jadoo-tech/Exoskeleton_public/README.md

# This project has moved

Development continues in **[jadoo-tech/unified_server](https://github.com/jadoo-tech/unified_server)**.

Contact **Dr. Waqas Khalid** for GitHub access.
