jadoo-tech/Exoskeleton_public/Kicad Files/EEG kicad/report.txt

Plotted to '/Users/ynk/Desktop/beyond curriculum/Nanotech/Exoskeleton/Exoskeleton_public/Kicad Files/EEG kicad/EEG2-F_Cu.gbr'.
Plotted to '/Users/ynk/Desktop/beyond curriculum/Nanotech/Exoskeleton/Exoskeleton_public/Kicad Files/EEG kicad/EEG2-B_Cu.gbr'.
Plotted to '/Users/ynk/Desktop/beyond curriculum/Nanotech/Exoskeleton/Exoskeleton_public/Kicad Files/EEG kicad/EEG2-F_Paste.gbr'.
Plotted to '/Users/ynk/Desktop/beyond curriculum/Nanotech/Exoskeleton/Exoskeleton_public/Kicad Files/EEG kicad/EEG2-B_Paste.gbr'.
Plotted to '/Users/ynk/Desktop/beyond curriculum/Nanotech/Exoskeleton/Exoskeleton_public/Kicad Files/EEG kicad/EEG2-F_Silkscreen.gbr'.
Plotted to '/Users/ynk/Desktop/beyond curriculum/Nanotech/Exoskeleton/Exoskeleton_public/Kicad Files/EEG kicad/EEG2-B_Silkscreen.gbr'.
Plotted to '/Users/ynk/Desktop/beyond curriculum/Nanotech/Exoskeleton/Exoskeleton_public/Kicad Files/EEG kicad/EEG2-F_Mask.gbr'.
Plotted to '/Users/ynk/Desktop/beyond curriculum/Nanotech/Exoskeleton/Exoskeleton_public/Kicad Files/EEG kicad/EEG2-B_Mask.gbr'.
Plotted to '/Users/ynk/Desktop/beyond curriculum/Nanotech/Exoskeleton/Exoskeleton_public/Kicad Files/EEG kicad/EEG2-Edge_Cuts.gbr'.
Created Gerber job file '/Users/ynk/Desktop/beyond curriculum/Nanotech/Exoskeleton/Exoskeleton_public/Kicad Files/EEG kicad/EEG2-job.gbrjob'.
Info: Done.
