jadoo-tech/Exoskeleton_public/Kicad Files/AR Glass/AugmentedGlassesPinout_v1.pdf

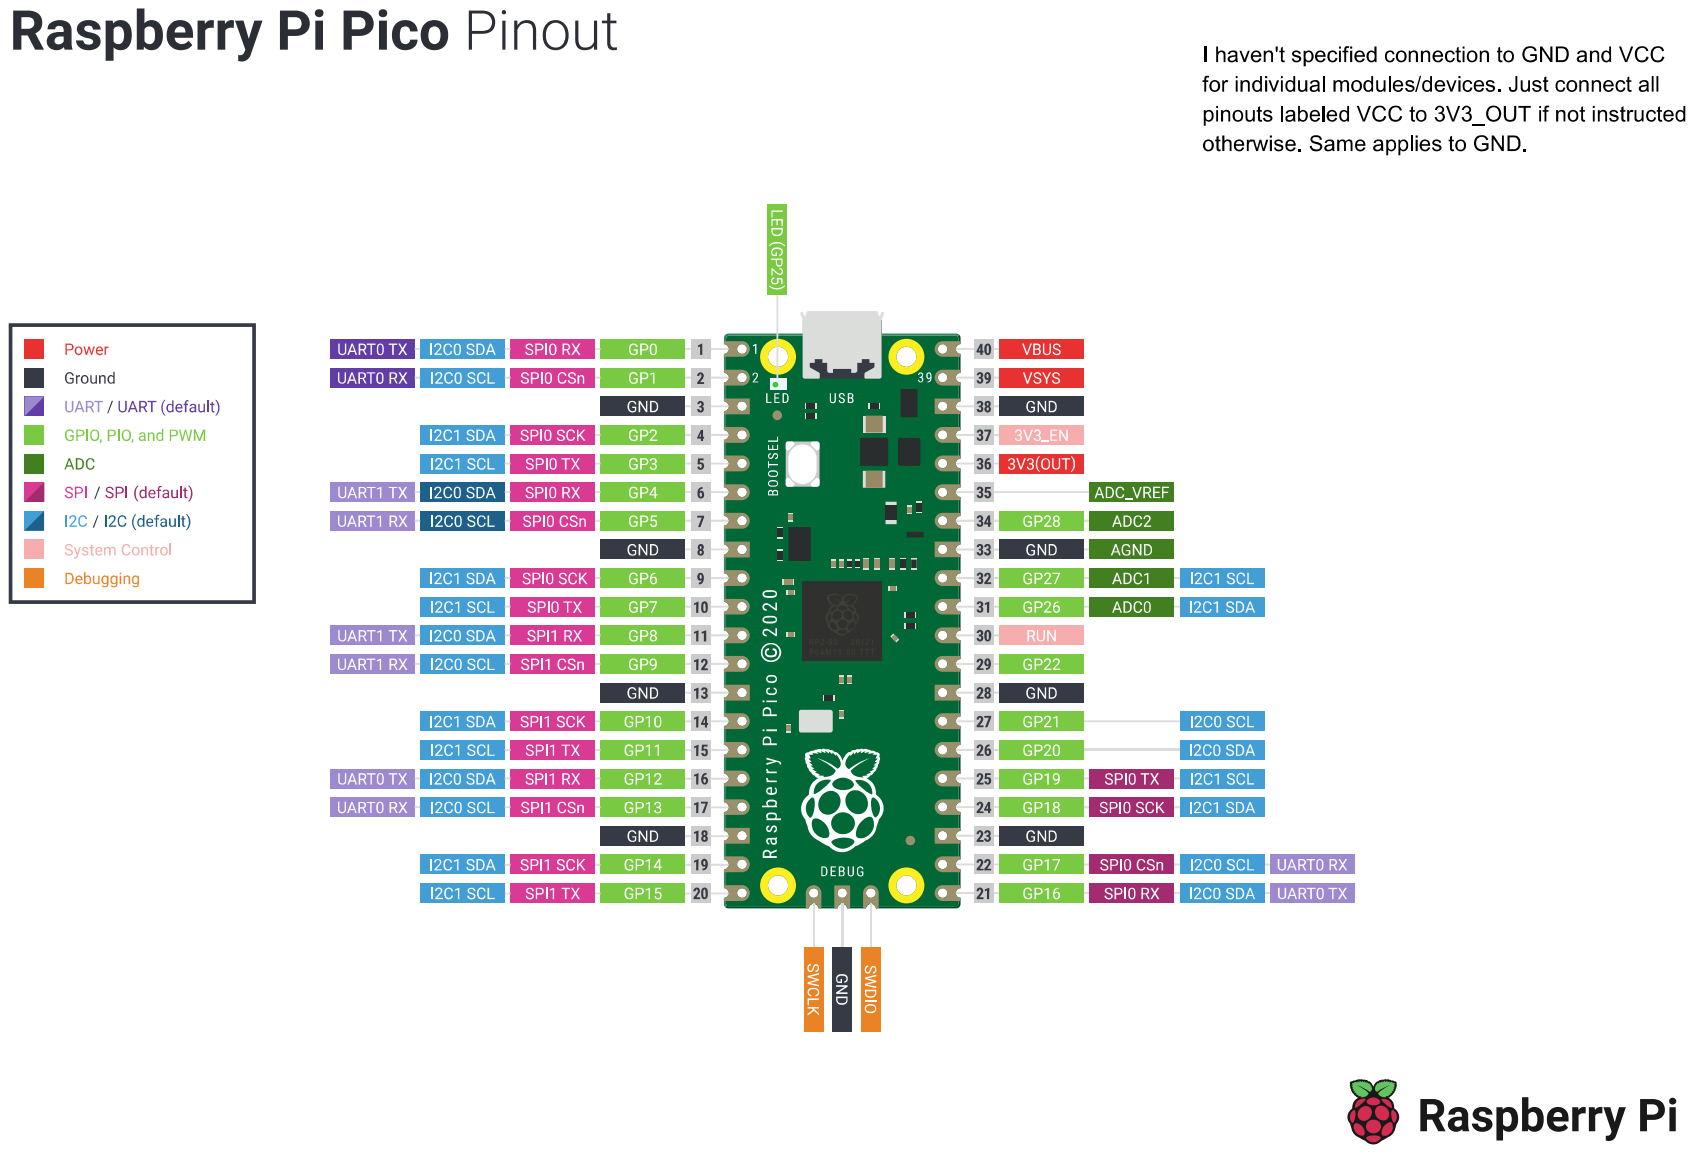
[picture p1: page 1]

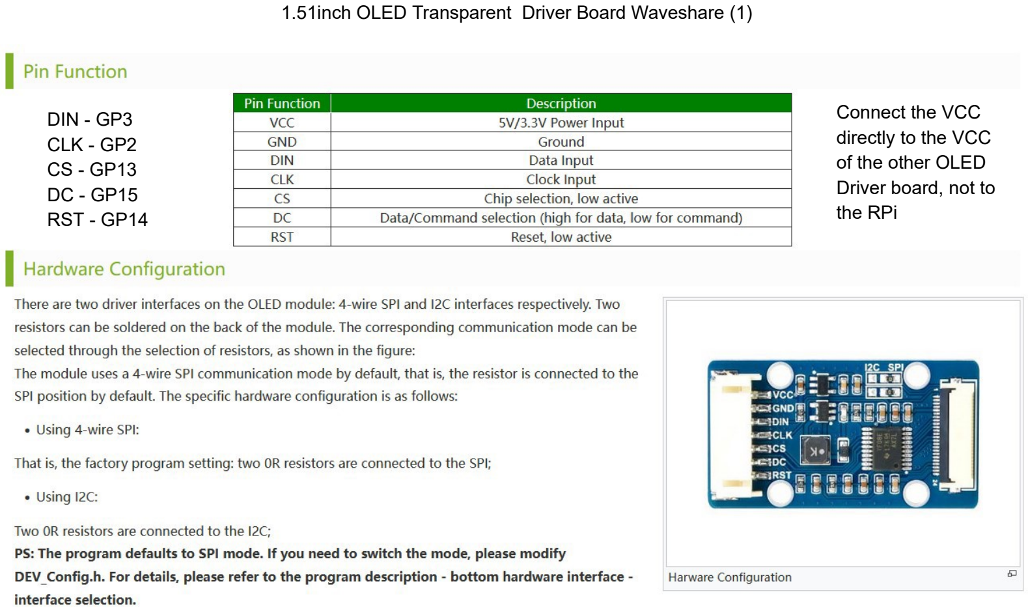
[picture p2: page 2]

1.51inch OLED Transparent Driver Board Waveshare (1)

DIN - GP3
CLK - GP2
CS - GP13
DC - GP15
RST - GP14

Connect the VCC
directly to the VCC
of the other OLED
Driver board, not to
the RPi

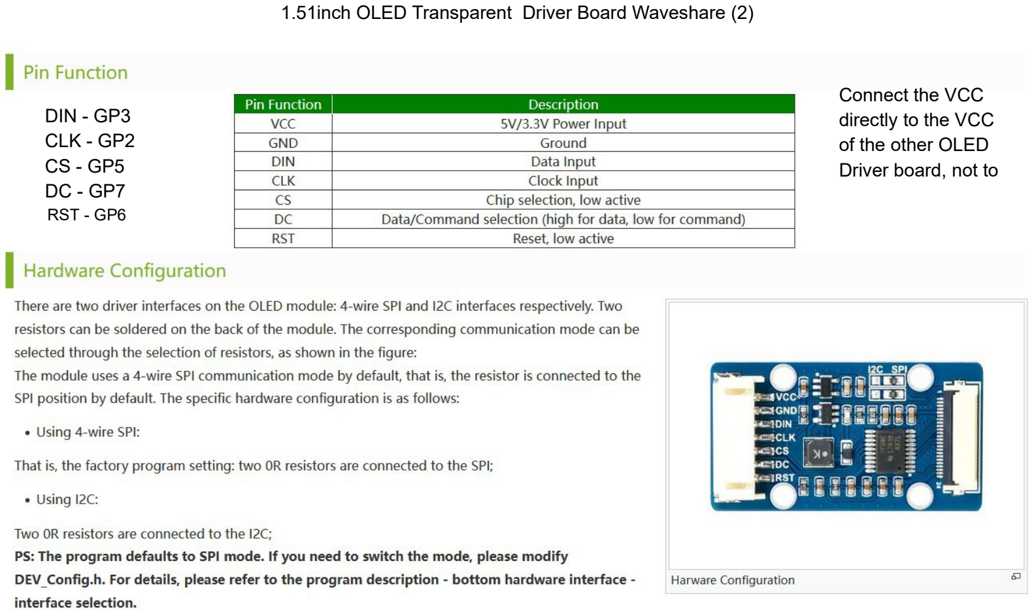
[picture p3: page 3]

1.51inch OLED Transparent Driver Board Waveshare (2)

DIN - GP3
CLK - GP2
CS - GP5
DC - GP7

Connect the VCC
directly to the VCC
of the other OLED
Driver board, not to

RST - GP6

### HM01B0 Arducam Camera Module

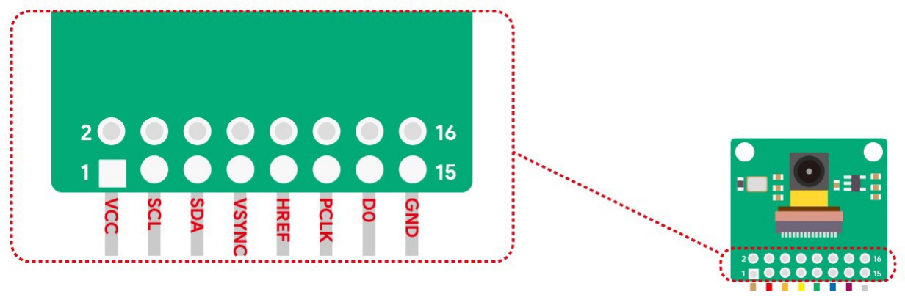
[picture p4: figure]

### SCL - GP21 SDA - GP20 VSYNC - GP16 HREF - GP19 PCLK - GP18 DO - GP10
