jadoo-tech/Exoskeleton_public/Kicad Files/EEG/FFT .png

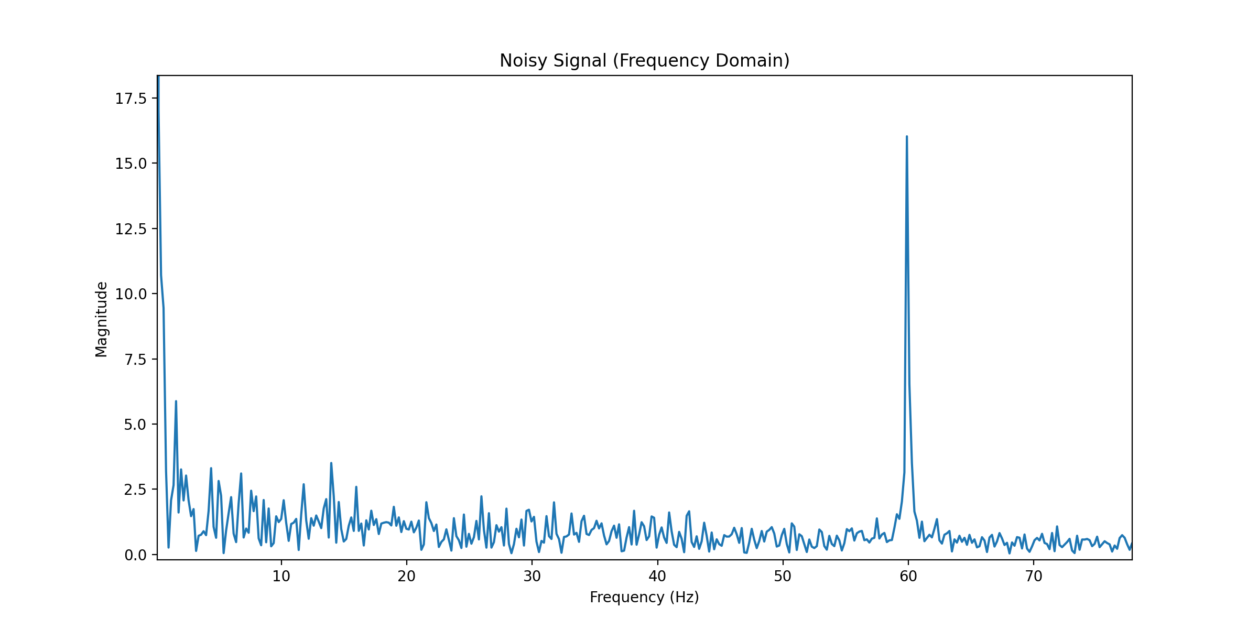
Kicad Files/EEG/FFT .png
