jadoo-tech/Exoskeleton_public/Kicad Files/EEG/filtered.png

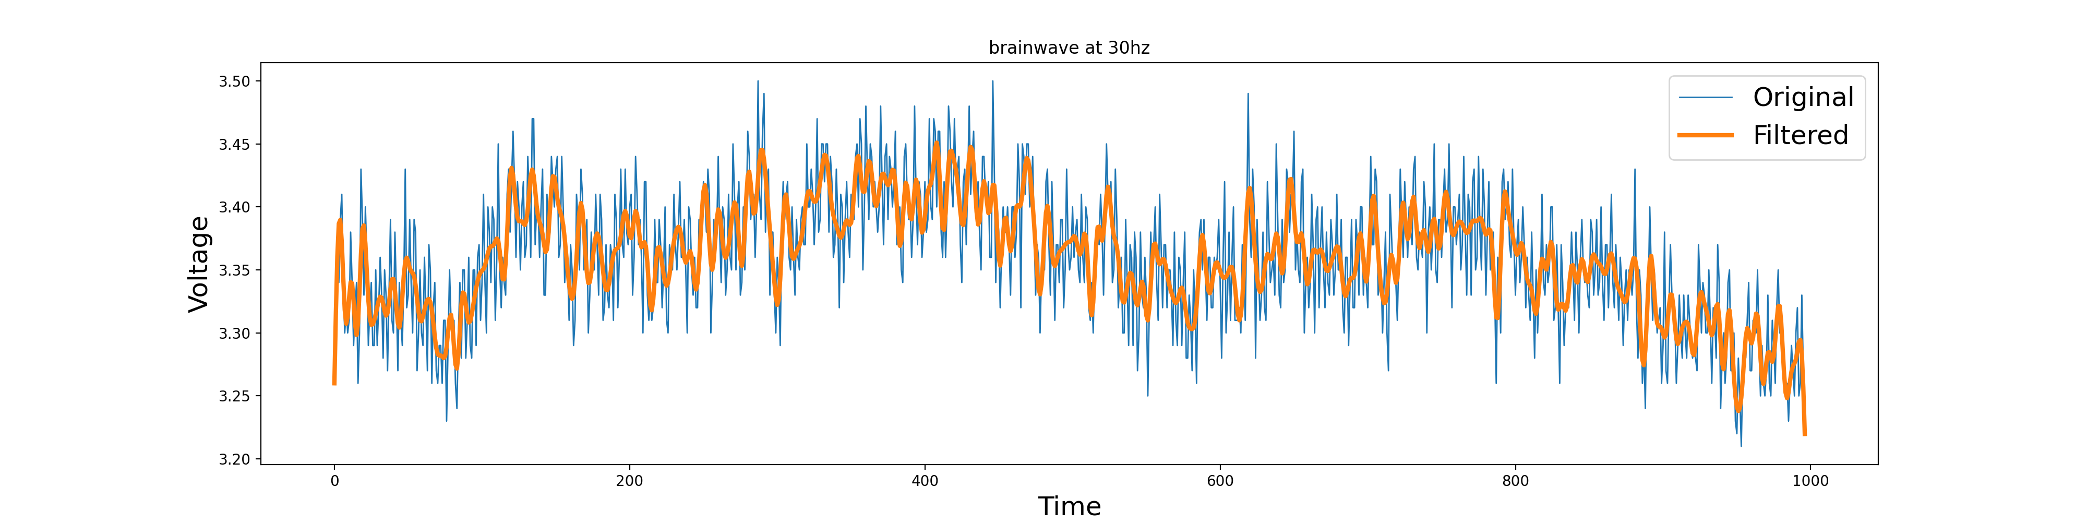
Kicad Files/EEG/filtered.png
