jadoo-tech/Exoskeleton_public/Kicad Files/EEG/output.png

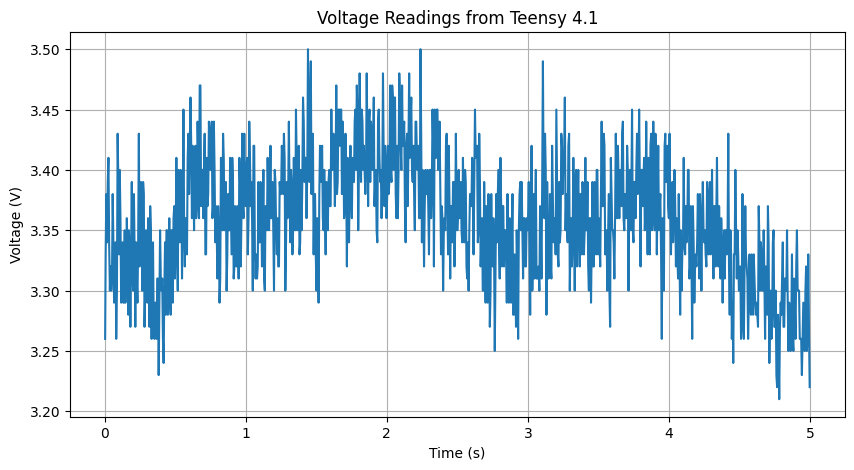
Kicad Files/EEG/output.png
