jadoo-tech/Exoskeleton_public/Microcontroller Codes/Motor/Connection.jpeg

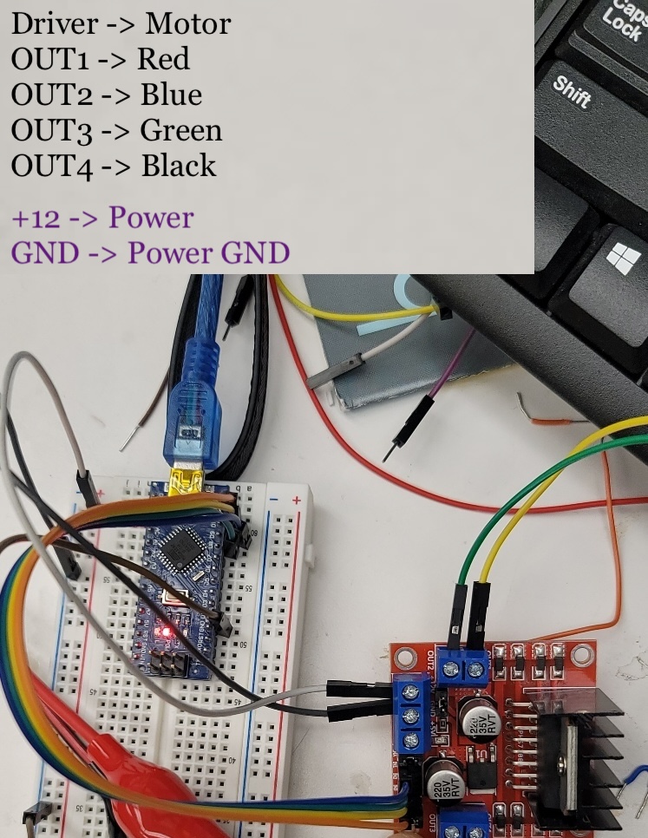
Microcontroller Codes/Motor/Connection.jpeg
