jadoo-tech/Exoskeleton_public/Microcontroller Codes/Motor/Motor_Specification.png

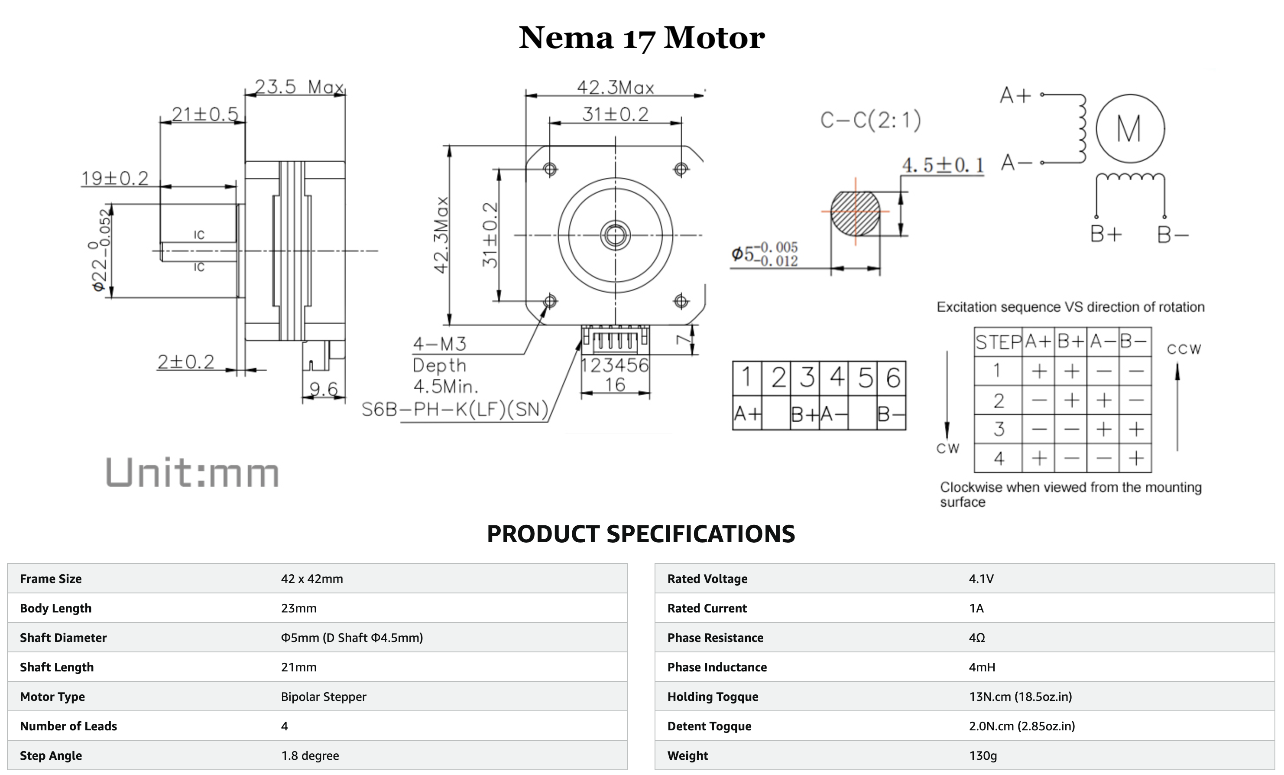
Microcontroller Codes/Motor/Motor_Specification.png
