jadoo-tech/Exoskeleton_public/Kicad Files/EEG kicad — no golden fingers/EEGBOM.xls

Reference | Value | Datasheet | Footprint | Qty | Unit price | Total price ($) | Product Link
C1,C2,C3,C7,C8,C9,C10,C14,C15,C16,C17,C18,C19,C20,C27,C28,C29,C30,C31,C35,C36,C37,C38,C39,C40,C41,C42,C43,C44,C45,C46,C47,C48,C49,C50,C85,C86,C87,C88,C89,C94,C96,C97,C98,C99,C143,C144,C145,C146,C147 | 1uF | ~ | Capacitor_SMD:C_0805_2012Metric | 50 | 0.84 | 42 | https://www.digikey.com/en/products/detail/yageo/CC0805JKX7R9BB105/7164382
C4,C5,C6,C11,C12,C13,C21,C22,C23,C24,C25,C26,C32,C33,C34,C100,C101,C102,C103,C104,C105,C106,C107,C108,C109,C110,C111,C112,C141,C142 | 0.22uF | ~ | Capacitor_SMD:C_0603_1608Metric | 30 | 2.986 | 89.58 | https://www.digikey.com/en/products/detail/kemet/C1206C224F3JACTU/6178652
J1 | Conn_01x05_Pin | ~ | Connector_PinHeader_1.27mm:PinHeader_1x05_P1.27mm_Vertical | 1 |  | 0
J2 | Conn_01x11_Pin | ~ | Connector_PinHeader_1.27mm:PinHeader_1x11_P1.27mm_Vertical | 1 |  | 0
R1,R6,R9,R10,R13,R18,R21,R22,R25,R26,R34,R36,R41,R42,R43,R44,R49,R54,R57,R58,R145,R146,R147,R148,R149,R166,R168,R170,R173,R176,R185,R186,R187,R188,R189,R190,R191,R192,R242,R243 | 1k | ~ |  | 40 | 0.02 | 0.8 | https://www.digikey.com/en/products/detail/panasonic-electronic-components/ERJ-2RKF1001X/79729
R2,R4,R14,R16,R27,R28,R31,R32,R50,R52,R150,R151,R152,R154,R156,R160,R161,R162,R163,R164 | 2652 | ~ |  | 20 | 0.11 | 2.2 | https://www.digikey.com/en/products/detail/yageo/RT0603BRD072K64L/5927921
R3,R15,R29,R30,R51,R153,R155,R157,R158,R159 | 1326 | ~ |  | 10 | 0.97 | 9.7 | https://www.digikey.com/en/products/detail/koa-speer-electronics-inc/RN73R2ATTD1321B05/10024879
R5,R17,R33,R35,R53,R165,R167,R169,R172,R175 | 100 | ~ |  | 10 | 0.1 | 1 | https://www.digikey.com/en/products/detail/panasonic-electronic-components/ERA-6AEB101V/1465724
R7,R8,R11,R19,R20,R23,R37,R38,R39,R40,R45,R46,R55,R56,R59,R171,R174,R177,R178,R179,R180,R181,R182,R183,R184,R241,R244,R245,R246,R247 | 10k | ~ |  | 30 | 0.106 | 3.18 | https://www.digikey.com/en/products/detail/yageo/RT0603BRD0710KL/1072198
R12,R24,R47,R48,R60,R248,R249,R250,R251,R252 | 150k | ~ |  | 10 | $0.01 | 0.14 | https://www.digikey.com/en/products/detail/stackpole-electronics-inc/RMCF0402FT150K/1761849
U1,U14,U25,U26,U32,U124,U125,U126,U127,U128 | AD5293 | https://www.analog.com/media/en/technical-documentation/data-sheets/AD5293.pdf | Package_SO:TSSOP-14_4.4x5mm_P0.65mm | 10 | $5.52 | 55.16 | https://www.digikey.com/en/products/detail/analog-devices-inc/AD5293BRUZ-100/2237577
U2,U9,U15,U16,U27,U75,U76,U77,U78,U79 | INA823 | https://www.ti.com/lit/ds/symlink/ina333.pdf | Package_SO:VSSOP-8_3x3mm_P0.65mm | 10 | 1.833 | 18.33 | https://www.digikey.com/en/products/detail/texas-instruments/INA823DR/15853913
U3,U4,U5,U6,U10,U11,U12,U13,U17,U18,U19,U20,U21,U22,U23,U24,U28,U29,U30,U31,U80,U81,U82,U83,U84,U85,U86,U87,U88,U89,U90,U91,U92,U93,U94,U95,U96,U97,U98,U123 | LF356N | http://www.ti.com/lit/ds/symlink/lf357.pdf |  | 40 | 1.038 | 41.52 | https://www.digikey.com/en/products/detail/texas-instruments/LF356M/3701382
U7 | Teensy4.1 |  | EEG Project:Teensy41 | 1 | 39.6 | 39.6 | https://www.digikey.com/en/products/detail/sparkfun-electronics/DEV-16996/13158152
