jadoo-tech/Exoskeleton_public/Kicad Files/AR Glass/dxf/Glass-Edge_Cuts.dxf

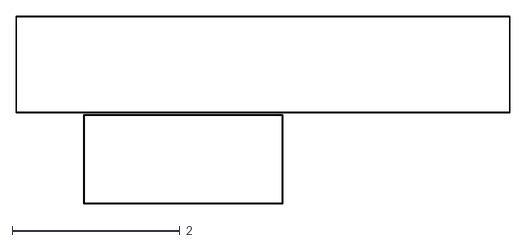
[picture p10: CAD file, 2024-10-15]
Kicad Files/AR Glass/dxf/Glass-Edge_Cuts.dxf
5.89 x 2.24
