jadoo-tech/Exoskeleton_public/Kicad Files/KiCad Libraries/AD5293/AD5293.step

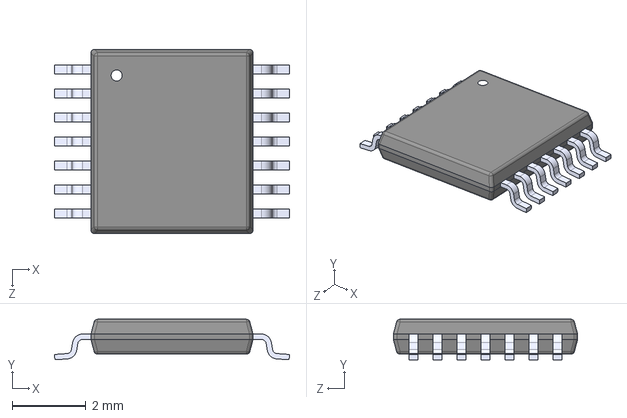
[picture p11: CAD file, 2024-11-18]
Kicad Files/KiCad Libraries/AD5293/AD5293.step
6.38 x 1.10 x 5.00 mm
