jadoo-tech/Exoskeleton_public/Kicad Files/KiCad Libraries/LF356M/LF356M.step

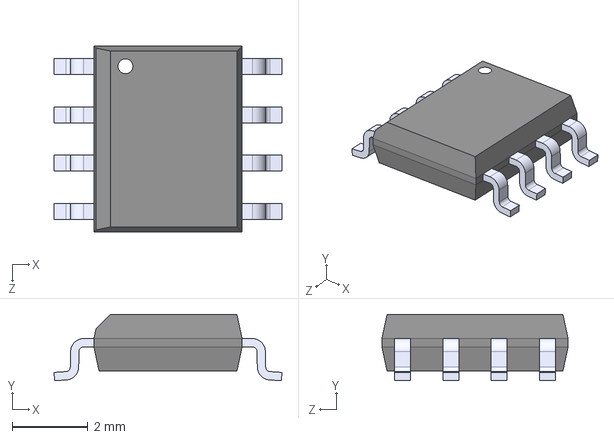
[picture p12: CAD file, 2024-11-18]
Kicad Files/KiCad Libraries/LF356M/LF356M.step
6.00 x 1.75 x 4.90 mm
