jadoo-tech/Exoskeleton_public/Kicad Files/AR Glass/dxf/Glass-B_Cu.dxf

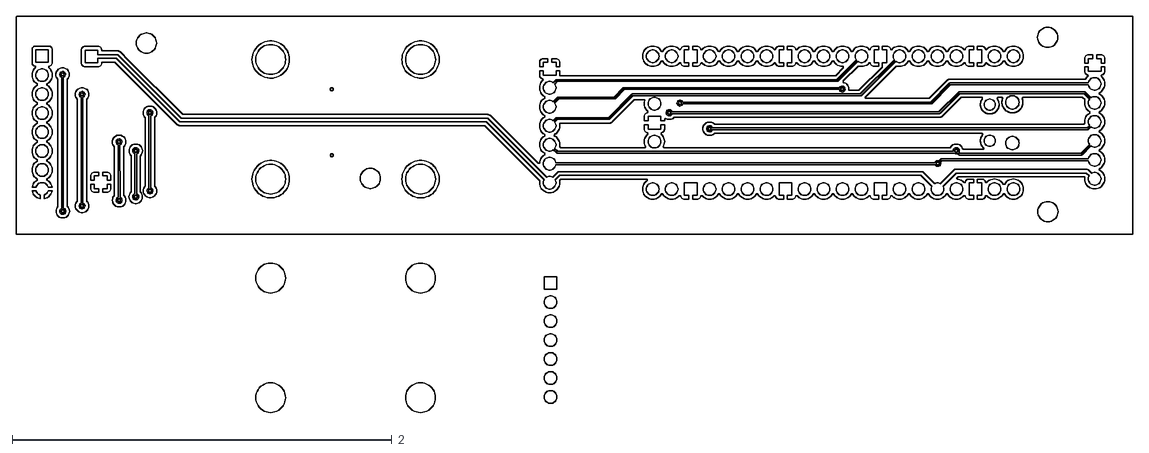
[picture p13: CAD file, 2024-10-15]
Kicad Files/AR Glass/dxf/Glass-B_Cu.dxf
5.88 x 2.09
