jadoo-tech/Exoskeleton_public/Kicad Files/AR Glass/dxf/Glass-F_Cu.dxf

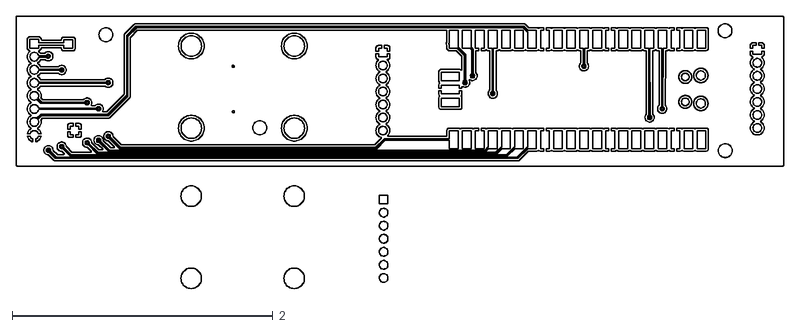
[picture p14: CAD file, 2024-10-15]
Kicad Files/AR Glass/dxf/Glass-F_Cu.dxf
5.88 x 2.09
