jadoo-tech/Exoskeleton_public/(list of files, cad)

Other CAD files:
Kicad Files/AR Glass/dxf/Glass-B_Mask.dxf
Kicad Files/AR Glass/dxf/Glass-B_Paste.dxf
Kicad Files/AR Glass/dxf/Glass-B_Silkscreen.dxf
Kicad Files/AR Glass/dxf/Glass-F_Mask.dxf
Kicad Files/AR Glass/dxf/Glass-F_Paste.dxf
Kicad Files/AR Glass/dxf/Glass-F_Silkscreen.dxf
