jadoo-tech/Exoskeleton_public/Kicad Files/EEG/EEG2.pdf

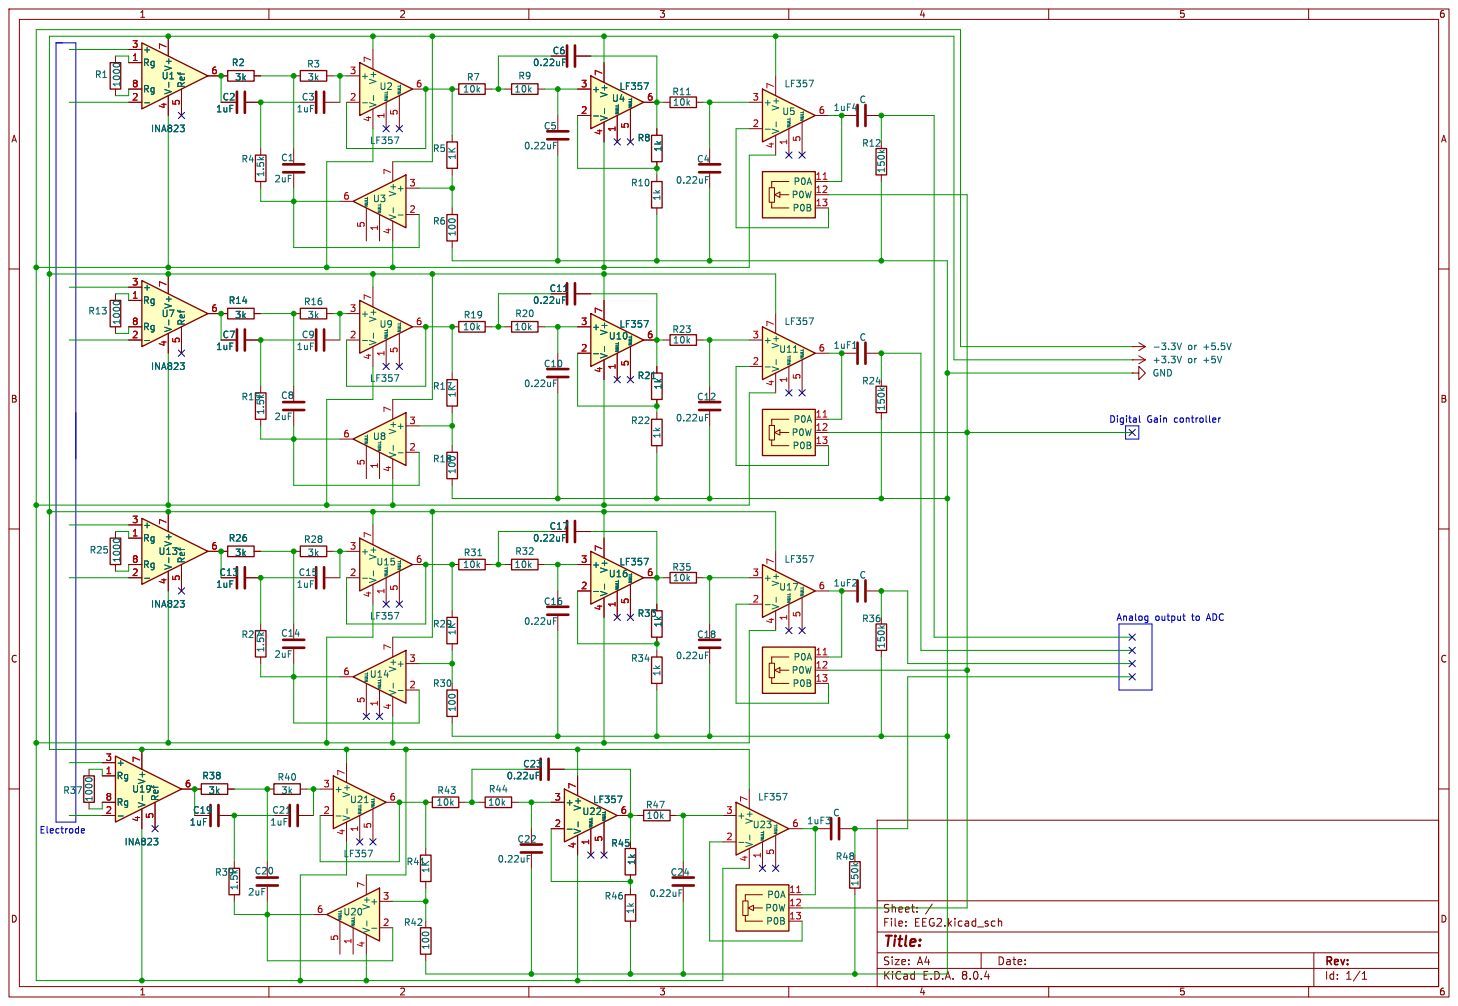
[picture p17: page 1]

Id: 1/1 Title: File: EEG2.kicad_sch Sheet: /
