jadoo-tech/Exoskeleton_public/Kicad Files/Old/EEG Circuits/Schematic_v1.pdf

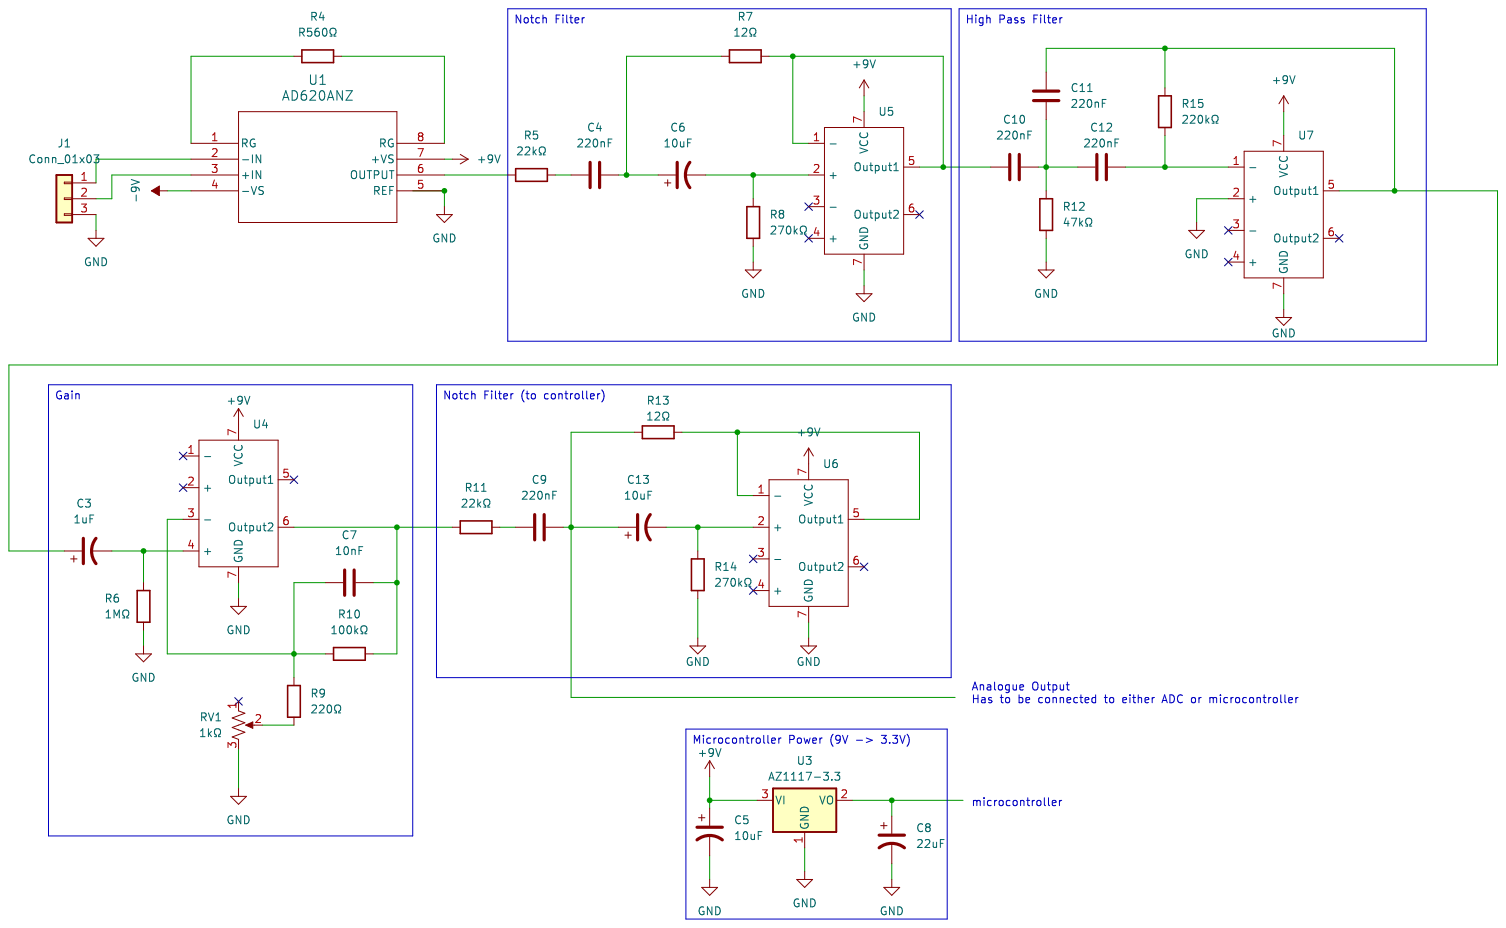
[picture p18: page 1]
