jadoo-tech/Exoskeleton_public/Kicad Files/Heater/Limb_Circuit.kicad_pcb

## KiCad design Kicad Files/Heater/Limb_Circuit.kicad_pcb (2025-03-16)

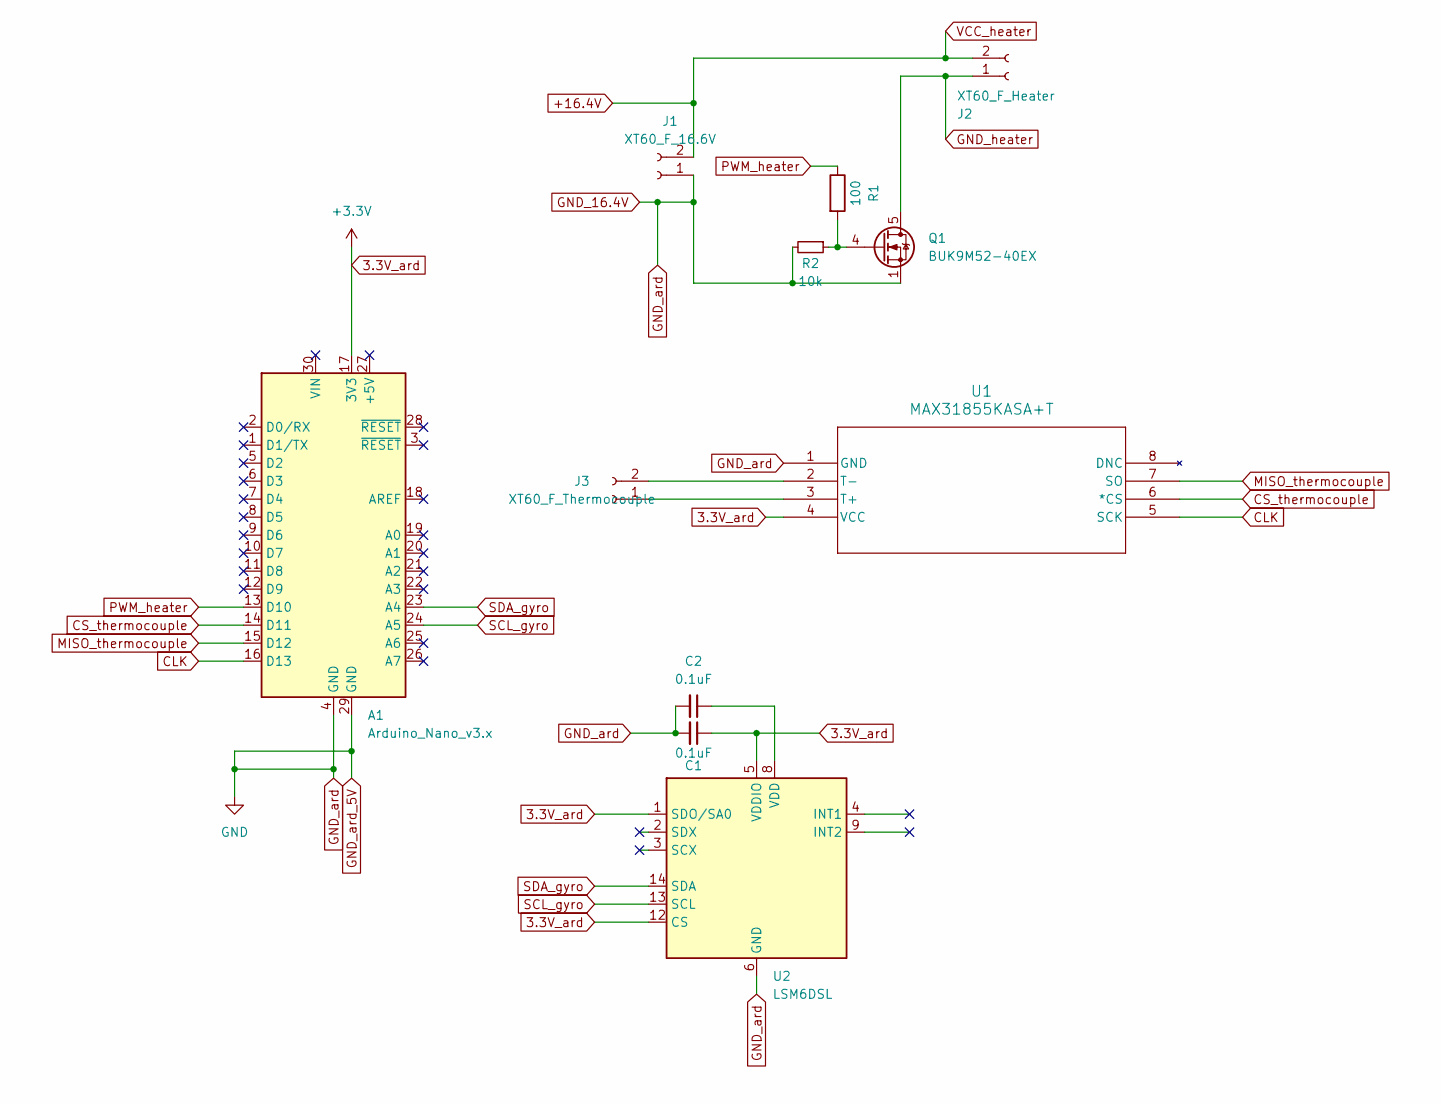
[picture p19: schematic Limb_Circuit.kicad_sch]

Parts:
A1: Arduino_Nano_v3.x; Arduino_Nano
C1, C2: 0.1uF; C_0402_1005Metric
J1: XT60_F_16.6V; AMASS_XT60PW-M_1x02_P7.20mm_Horizontal
J2: XT60_F_Heater; AMASS_XT60PW-M_1x02_P7.20mm_Horizontal
J3: XT60_F_Thermocouple; AMASS_XT60PW-M_1x02_P7.20mm_Horizontal
Q1: BUK9M52-40EX; LFPAK33
R1: 100; R_0805_2012Metric
R2: 10k; R_0805_2012Metric
U1: MAX31855KASA+T; 21-0041B_8_MXM
U2: LSM6DSL; LGA-14_3x2.5mm_P0.5mm_LayoutBorder3x4y

Connections:
3.3V_ard: A1.17 (3V3), C1.1, U1.4 (VCC), U2.1 (SDO/SA0), U2.5 (VDDIO), U2.12 (CS)
+16.4V: J1.2, J2.2
CLK: A1.16 (D13), U1.5 (SCK)
CS_thermocouple: A1.14 (D11), U1.6 (*CS)
GND_16.4V: A1.4 (GND), A1.29 (GND), C1.2, C2.2, J1.1, Q1.1 (S), Q1.2 (S), Q1.3 (S), R2.2, U1.1 (GND), U2.6 (GND), U2.7 (GND)
GND_heater: J2.1, Q1.5 (D)
MISO_thermocouple: A1.15 (D12), U1.7 (SO)
unnamed: J3.1, U1.3 (T+)
unnamed: J3.2, U1.2 (T-)
unnamed: Q1.4 (G), R1.2, R2.1
unnamed: C2.1, U2.8 (VDD)
PWM_heater: A1.13 (D10), R1.1
SCL_gyro: A1.24 (A5), U2.13 (SCL)
SDA_gyro: A1.23 (A4), U2.14 (SDA)

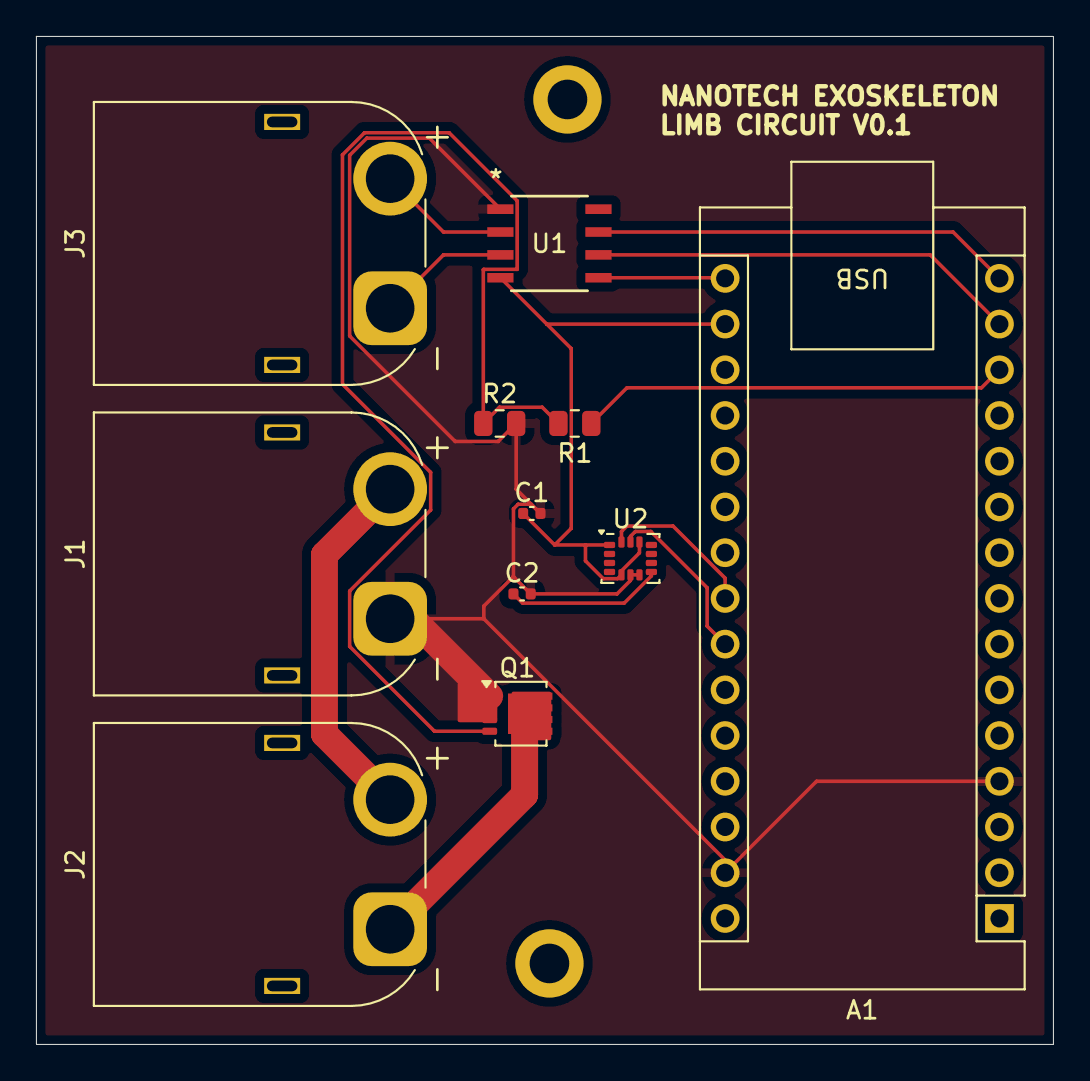
[picture p20: board Limb_Circuit.kicad_pcb from above]

Board: 2 copper layers, 56.5 x 56.0 mm, 11 parts (0 on the bottom side), 14 nets.
