jadoo-tech/Exoskeleton_public/Kicad Files/AR Glass/Glass.kicad_pcb

## KiCad design Kicad Files/AR Glass/Glass.kicad_pcb (2025-06-09)

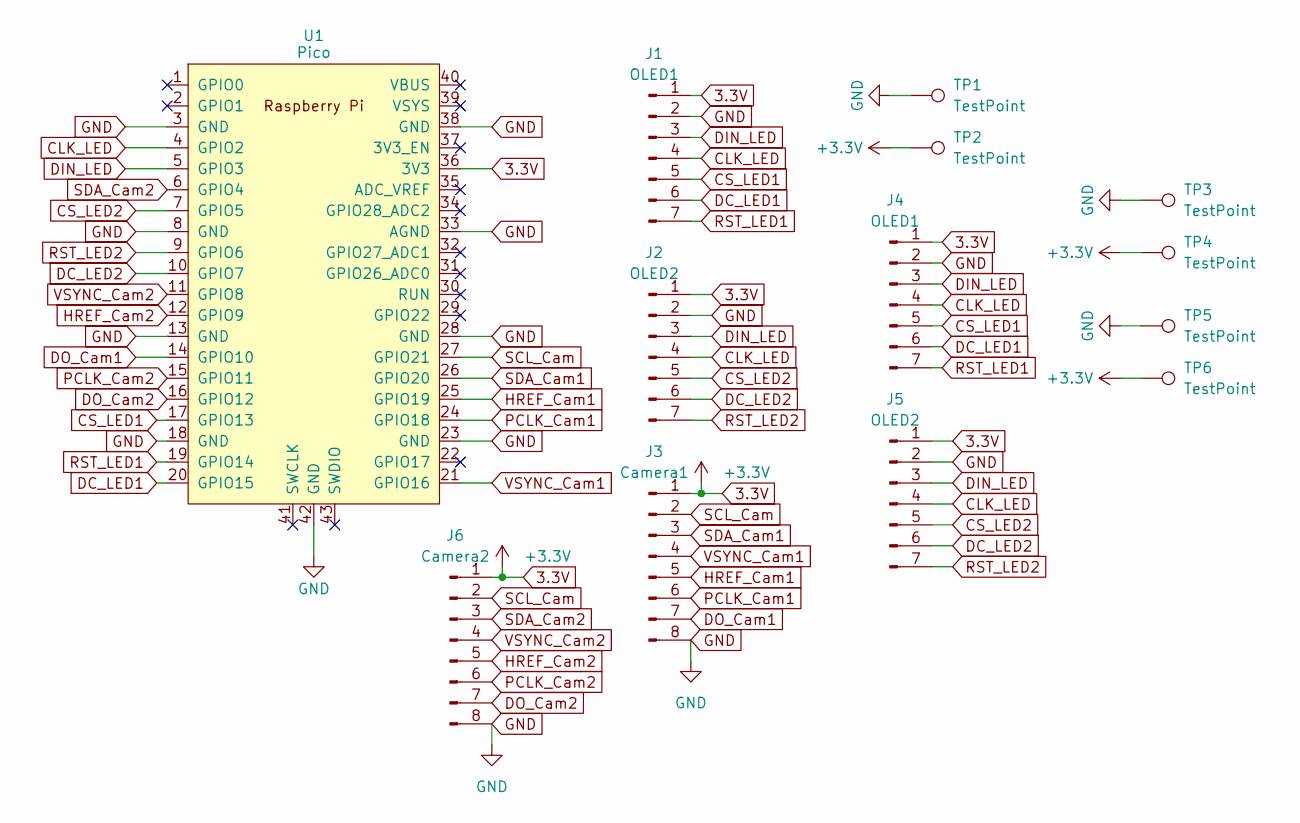
[picture p21: schematic Glass.kicad_sch]

Parts:
J1, J4: OLED1; Molex_54548-1071_1x10-1MP_P0.5mm_Horizontal
J2, J5: OLED2; Molex_54548-1071_1x10-1MP_P0.5mm_Horizontal
J3: Camera1; Molex_54548-1071_1x10-1MP_P0.5mm_Horizontal
J6: Camera2; Molex_54548-1071_1x10-1MP_P0.5mm_Horizontal
TP1, TP2, TP3, TP4, TP5, TP6: TestPoint; PinHeader_1x01_P2.54mm_Vertical
U1: Pico; RPi_Pico_SMD_TH

Connections:
3.3V: J1.1, J2.1, J3.1, J4.1, J5.1, J6.1, TP2.1, TP4.1, TP6.1, U1.36 (3V3)
CLK_LED: J1.4, J2.4, J4.4, J5.4, U1.4 (GPIO2)
CS_LED1: J1.5, J4.5, U1.17 (GPIO13)
CS_LED2: J2.5, J5.5, U1.7 (GPIO5)
DC_LED1: J1.6, J4.6, U1.20 (GPIO15)
DC_LED2: J2.6, J5.6, U1.10 (GPIO7)
DIN_LED: J1.3, J2.3, J4.3, J5.3, U1.5 (GPIO3)
DO_Cam1: J3.7, U1.14 (GPIO10)
DO_Cam2: J6.7, U1.16 (GPIO12)
GND: J1.2, J2.2, J3.8, J4.2, J5.2, J6.8, TP1.1, TP3.1, TP5.1, U1.3 (GND), U1.8 (GND), U1.13 (GND), U1.18 (GND), U1.23 (GND), U1.28 (GND), U1.33 (AGND), U1.38 (GND), U1.42 (GND)
HREF_Cam1: J3.5, U1.25 (GPIO19)
HREF_Cam2: J6.5, U1.12 (GPIO9)
PCLK_Cam1: J3.6, U1.24 (GPIO18)
PCLK_Cam2: J6.6, U1.15 (GPIO11)
RST_LED1: J1.7, J4.7, U1.19 (GPIO14)
RST_LED2: J2.7, J5.7, U1.9 (GPIO6)
SCL_Cam: J3.2, J6.2, U1.27 (GPIO21)
SDA_Cam1: J3.3, U1.26 (GPIO20)
SDA_Cam2: J6.3, U1.6 (GPIO4)
VSYNC_Cam1: J3.4, U1.21 (GPIO16)
VSYNC_Cam2: J6.4, U1.11 (GPIO8)

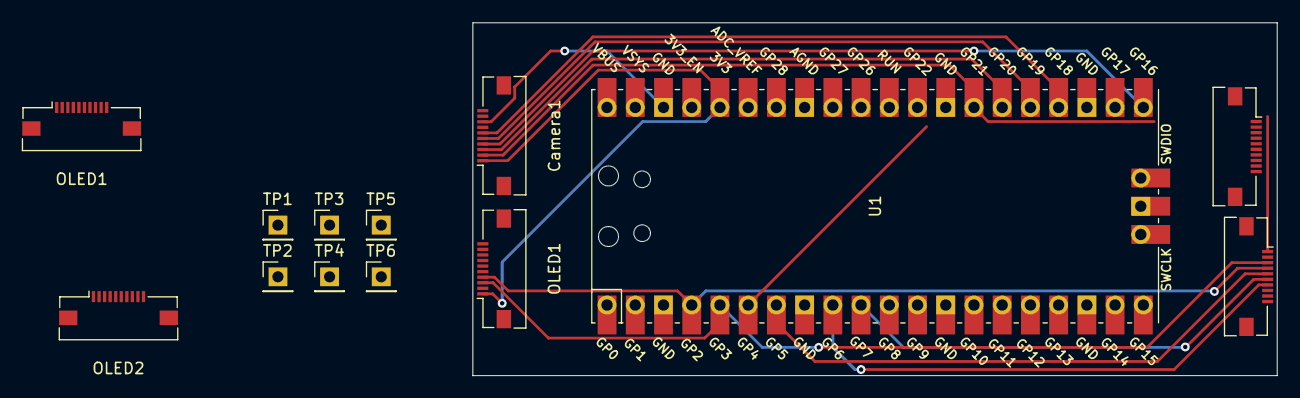
[picture p22: board Glass.kicad_pcb from above]

Board: 2 copper layers, 72.4 x 31.7 mm, 13 parts (0 on the bottom side), 21 nets.
