jadoo-tech/Exoskeleton_public/Kicad Files/EEG kicad/EEG2.kicad_pcb

## KiCad design Kicad Files/EEG kicad/EEG2.kicad_pcb (2025-03-03)

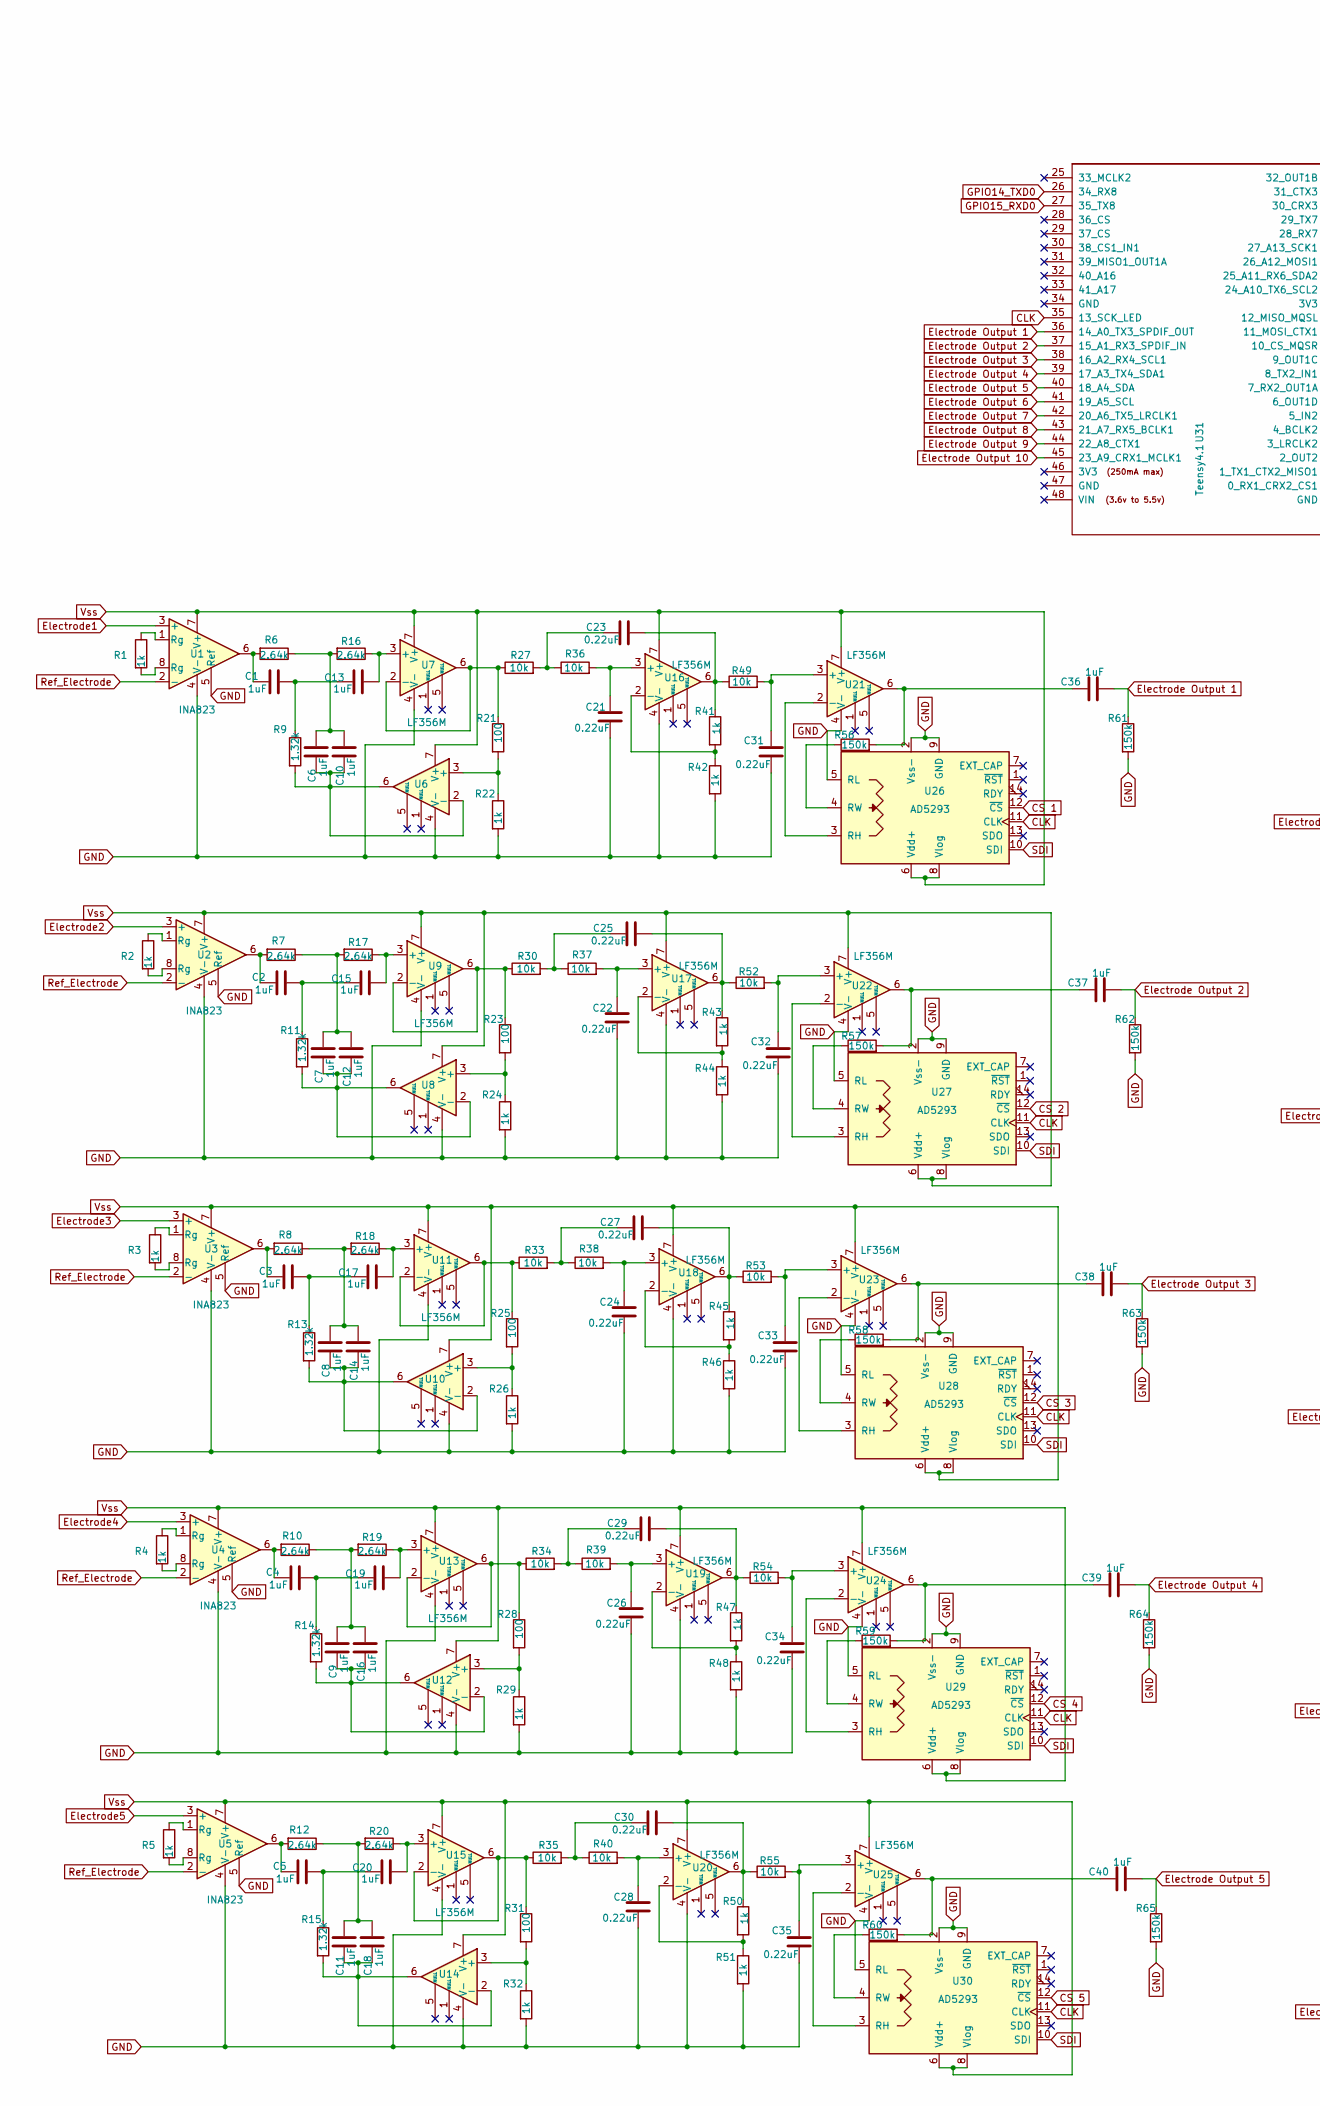
[picture p23: schematic EEG2.kicad_sch, part in row 1, column 1]

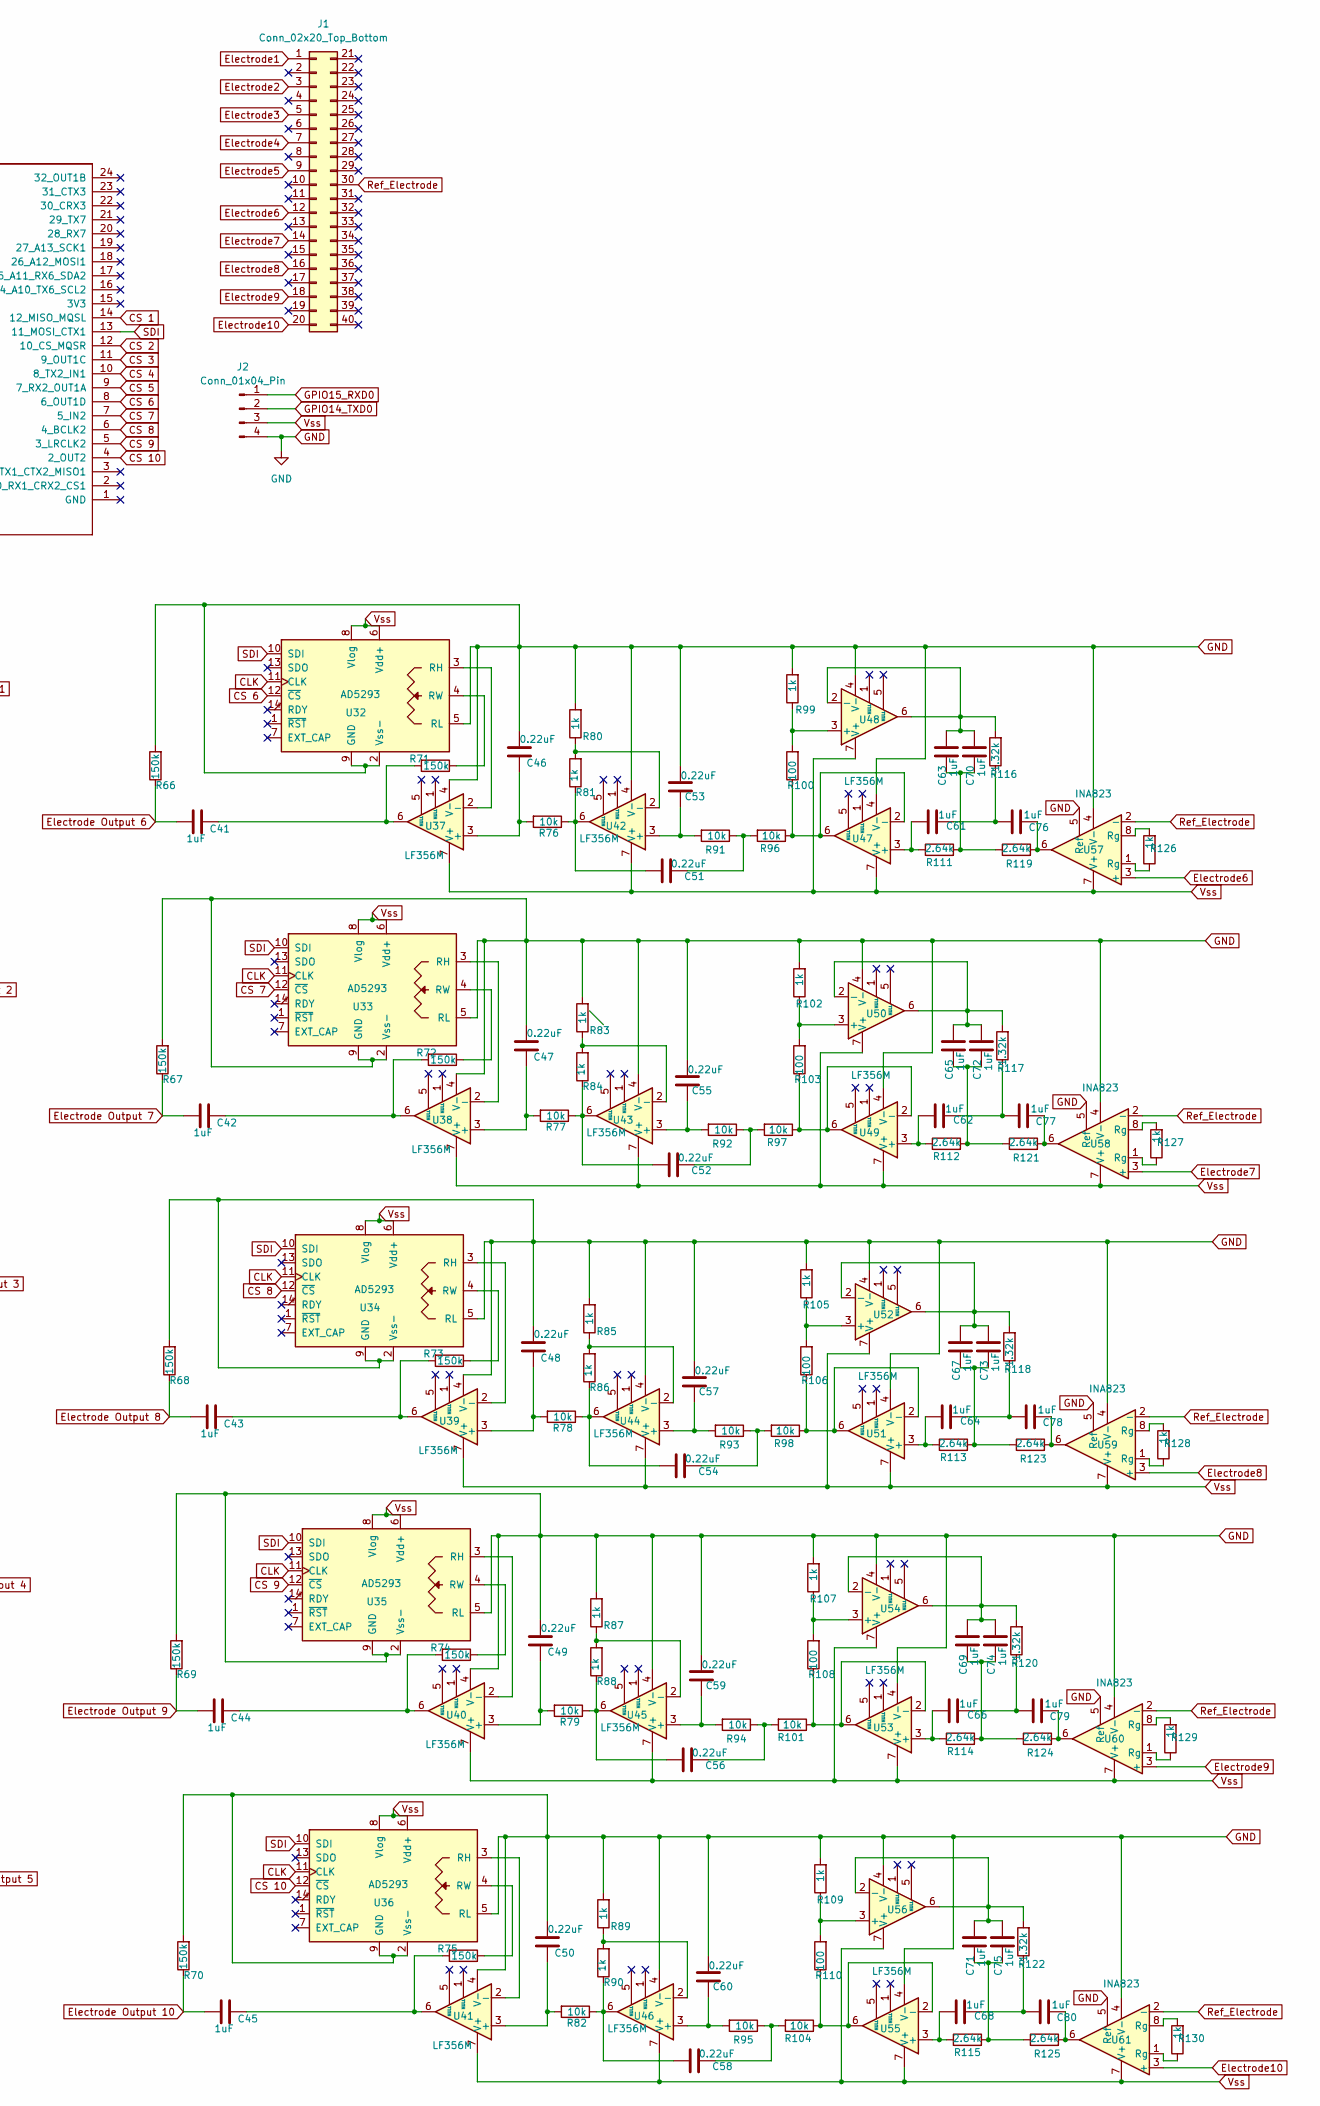
[picture p24: schematic EEG2.kicad_sch, part in row 1, column 2]

Parts:
C1, C2, C3, C4, C5, C6, C7, C8, C9, C10, C11, C12, C13, C14, C15, C16, C17, C18, C19, C20, C36, C37, C38, C39, C40, C41, C42, C43, C44, C45, C61, C62, C63, C64, C65, C66, C67, C68, C69, C70, C71, C72, C73, C74, C75, C76, C77, C78, C79, C80: 1uF; C_0805_2012Metric
C21, C22, C23, C24, C25, C26, C27, C28, C29, C30, C31, C32, C33, C34, C35, C46, C47, C48, C49, C50, C51, C52, C53, C54, C55, C56, C57, C58, C59, C60: 0.22uF; C_0603_1608Metric
J1: Conn_02x20_Top_Bottom; GoldFingers_1x40_0.155mm_DoubleSided
J2: Conn_01x04_Pin; PinHeader_1x04_P1.27mm_Vertical
R1, R2, R3, R4, R5, R22, R24, R26, R29, R32, R41, R42, R43, R44, R45, R46, R47, R48, R50, R51, R80, R81, R83, R84, R85, R86, R87, R88, R89, R90, R99, R102, R105, R107, R109, R126, R127, R128, R129, R130: 1k; R_0402_1005Metric
R6, R7, R8, R10, R12, R16, R17, R18, R19, R20, R111, R112, R113, R114, R115, R119, R121, R123, R124, R125: 2.64k; R_0603_1608Metric
R9, R11, R13, R14, R15, R116, R117, R118, R120, R122: 1.32k; R_0805_2012Metric
R21, R23, R25, R28, R31, R100, R103, R106, R108, R110: 100; R_0805_2012Metric
R27, R30, R33, R34, R35, R36, R37, R38, R39, R40, R49, R52, R53, R54, R55, R76, R77, R78, R79, R82, R91, R92, R93, R94, R95, R96, R97, R98, R101, R104: 10k; R_0603_1608Metric
R56, R57, R58, R59, R60, R61, R62, R63, R64, R65, R66, R67, R68, R69, R70, R71, R72, R73, R74, R75: 150k; R_0402_1005Metric
U1, U2, U3, U4, U5, U57, U58, U59, U60, U61: INA823; VSSOP-8_3x3mm_P0.65mm
U6, U7, U8, U9, U10, U11, U12, U13, U14, U15, U16, U17, U18, U19, U20, U21, U22, U23, U24, U25, U37, U38, U39, U40, U41, U42, U43, U44, U45, U46, U47, U48, U49, U50, U51, U52, U53, U54, U55, U56: LF356M; SOIC127P599X175-8N
U26, U27, U28, U29, U30, U32, U33, U34, U35, U36: AD5293
U31: Teensy4.1; Teensy41

Connections:
CLK: U26.11 (CLK), U27.11 (CLK), U28.11 (CLK), U29.11 (CLK), U30.11 (CLK), U31.35 (13_SCK_LED), U32.11 (CLK), U33.11 (CLK), U34.11 (CLK), U35.11 (CLK), U36.11 (CLK)
CS 1: U26.12 (~CS), U31.14 (12_MISO_MQSL)
CS 2: U27.12 (~CS), U31.12 (10_CS_MQSR)
CS 3: U28.12 (~CS), U31.11 (9_OUT1C)
CS 4: U29.12 (~CS), U31.10 (8_TX2_IN1)
CS 5: U30.12 (~CS), U31.9 (7_RX2_OUT1A)
CS 6: U31.8 (6_OUT1D), U32.12 (~CS)
CS 7: U31.7 (5_IN2), U33.12 (~CS)
CS 8: U31.6 (4_BCLK2), U34.12 (~CS)
CS 9: U31.5 (3_LRCLK2), U35.12 (~CS)
CS 10: U31.4 (2_OUT2), U36.12 (~CS)
Electrode1: J1.1, U1.3 (+)
Electrode2: J1.3, U2.3 (+)
Electrode3: J1.5, U3.3 (+)
Electrode4: J1.7, U4.3 (+)
Electrode5: J1.9, U5.3 (+)
Electrode6: J1.12, U57.3 (+)
Electrode7: J1.14, U58.3 (+)
Electrode8: J1.16, U59.3 (+)
Electrode9: J1.18, U60.3 (+)
Electrode10: J1.20, U61.3 (+)
Electrode Output 1: C36.2, R61.1, U31.36 (14_A0_TX3_SPDIF_OUT)
Electrode Output 2: C37.2, R62.1, U31.37 (15_A1_RX3_SPDIF_IN)
Electrode Output 3: C38.2, R63.1, U31.38 (16_A2_RX4_SCL1)
Electrode Output 4: C39.2, R64.1, U31.39 (17_A3_TX4_SDA1)
Electrode Output 5: C40.2, R65.1, U31.40 (18_A4_SDA)
Electrode Output 6: C41.2, R66.1, U31.41 (19_A5_SCL)
Electrode Output 7: C42.2, R67.1, U31.42 (20_A6_TX5_LRCLK1)
Electrode Output 8: C43.2, R68.1, U31.43 (21_A7_RX5_BCLK1)
Electrode Output 9: C44.2, R69.1, U31.44 (22_A8_CTX1)
Electrode Output 10: C45.2, R70.1, U31.45 (23_A9_CRX1_MCLK1)
GND: C21.2, C22.2, C24.2, C26.2, C28.2, C31.2, C32.2, C33.2, C34.2, C35.2, C46.2, C47.2, C48.2, C49.2, C50.2, C53.2, C55.2, C57.2, C59.2, C60.2, J2.4, R22.2, R24.2, R26.2, R29.2, R32.2, R42.2, R44.2, R46.2, R48.2, R51.2, R61.2, R62.2, R63.2, R64.2, R65.2, R66.2, R67.2, R68.2, R69.2, R70.2, R80.2, R83.2, R85.2, R87.2, R89.2, R99.2, R102.2, R105.2, R107.2, R109.2, U1.4 (V-), U1.5 (Ref), U2.4 (V-), U2.5 (Ref), U3.4 (V-), U3.5 (Ref), U4.4 (V-), U4.5 (Ref), U5.4 (V-), U5.5 (Ref), U6.4 (V-), U7.4 (V-), U8.4 (V-), U9.4 (V-), U10.4 (V-), U11.4 (V-), U12.4 (V-), U13.4 (V-), U14.4 (V-), U15.4 (V-), U16.4 (V-), U17.4 (V-), U18.4 (V-), U19.4 (V-), U20.4 (V-), U21.4 (V-), U22.4 (V-), U23.4 (V-), U24.4 (V-), U25.4 (V-), U26.2 (Vss-), U26.5 (RL), U26.9 (GND), U27.2 (Vss-), U27.5 (RL), U27.9 (GND), U28.2 (Vss-), U28.5 (RL), U28.9 (GND), U29.2 (Vss-), U29.5 (RL), U29.9 (GND), U30.2 (Vss-), U30.5 (RL), U30.9 (GND), U32.2 (Vss-), U32.5 (RL), U32.9 (GND), U33.2 (Vss-), U33.5 (RL), U33.9 (GND), U34.2 (Vss-), U34.5 (RL), U34.9 (GND), U35.2 (Vss-), U35.5 (RL), U35.9 (GND), U36.2 (Vss-), U36.5 (RL), U36.9 (GND), U37.4 (V-), U38.4 (V-), U39.4 (V-), U40.4 (V-), U41.4 (V-), U42.4 (V-), U43.4 (V-), U44.4 (V-), U45.4 (V-), U46.4 (V-), U47.4 (V-), U48.4 (V-), U49.4 (V-), U50.4 (V-), U51.4 (V-), U52.4 (V-), U53.4 (V-), U54.4 (V-), U55.4 (V-), U56.4 (V-), U57.4 (V-), U57.5 (Ref), U58.4 (V-), U58.5 (Ref), U59.4 (V-), U59.5 (Ref), U60.4 (V-), U60.5 (Ref), U61.4 (V-), U61.5 (Ref)
GPIO14_TXD0: J2.2, U31.26 (34_RX8)
GPIO15_RXD0: J2.1, U31.27 (35_TX8)
unnamed: C1.1, R6.2, U1.6
unnamed: C1.2, C13.1, R9.1
unnamed: C2.1, R7.2, U2.6
unnamed: C3.1, R8.2, U3.6
unnamed: C4.1, R10.2, U4.6
unnamed: C5.1, R12.2, U5.6
unnamed: C6.2, C10.2, R6.1, R16.2
unnamed: C11.2, C18.2, R12.1, R20.2
unnamed: C7.2, C12.2, R7.1, R17.2
unnamed: C8.2, C14.2, R8.1, R18.2
unnamed: C2.2, C15.1, R11.1
unnamed: C9.2, C16.2, R10.1, R19.2
unnamed: C3.2, C17.1, R13.1
unnamed: C4.2, C19.1, R14.1
unnamed: C5.2, C20.1, R15.1
unnamed: C23.1, R41.1, R49.1, U16.6
unnamed: C23.2, R27.2, R36.1
unnamed: C25.1, R43.1, R52.1, U17.6
unnamed: C25.2, R30.2, R37.1
unnamed: C27.1, R45.1, R53.1, U18.6
unnamed: C27.2, R33.2, R38.1
unnamed: C29.1, R47.1, R54.1, U19.6
unnamed: C29.2, R34.2, R39.1
unnamed: C30.1, R50.1, R55.1, U20.6
unnamed: C30.2, R35.2, R40.1
unnamed: C36.1, R56.2, U21.6
unnamed: C37.1, R57.2, U22.6
unnamed: C38.1, R58.2, U23.6
unnamed: C39.1, R59.2, U24.6
unnamed: C40.1, R60.2, U25.6
unnamed: C41.1, R71.2, U37.6
unnamed: C42.1, R72.2, U38.6
unnamed: C43.1, R73.2, U39.6
unnamed: C44.1, R74.2, U40.6
unnamed: C45.1, R75.2, U41.6
unnamed: C51.1, R76.1, R81.1, U42.6
unnamed: C51.2, R91.1, R96.2
unnamed: C52.1, R77.1, R84.1, U43.6
unnamed: C52.2, R92.1, R97.2
unnamed: C54.1, R78.1, R86.1, U44.6
unnamed: C54.2, R93.1, R98.2
unnamed: C56.1, R79.1, R88.1, U45.6
unnamed: C56.2, R94.1, R101.2
unnamed: C58.1, R82.1, R90.1, U46.6
unnamed: C58.2, R95.1, R104.2
unnamed: C61.1, C76.2, R116.1
unnamed: C62.1, C77.2, R117.1
unnamed: C63.1, C70.1, R111.2, R119.1
unnamed: C64.1, C78.2, R118.1
unnamed: C65.1, C72.1, R112.2, R121.1
unnamed: C66.1, C79.2, R120.1
unnamed: C67.1, C73.1, R113.2, R123.1
unnamed: C68.1, C80.2, R122.1
unnamed: C69.1, C74.1, R114.2, R124.1
unnamed: C71.1, C75.1, R115.2, R125.1
unnamed: C76.1, R119.2, U57.6
unnamed: C77.1, R121.2, U58.6
unnamed: C78.1, R123.2, U59.6
unnamed: C79.1, R124.2, U60.6
unnamed: C80.1, R125.2, U61.6
unnamed: R1.1, U1.1 (Rg)
unnamed: R1.2, U1.8 (Rg)
unnamed: R2.1, U2.1 (Rg)
unnamed: R2.2, U2.8 (Rg)
unnamed: R3.1, U3.1 (Rg)
unnamed: R3.2, U3.8 (Rg)
unnamed: R4.1, U4.1 (Rg)
unnamed: R4.2, U4.8 (Rg)
unnamed: R5.1, U5.1 (Rg)
unnamed: R5.2, U5.8 (Rg)
unnamed: R126.1, U57.1 (Rg)
unnamed: R126.2, U57.8 (Rg)
unnamed: R127.1, U58.1 (Rg)
unnamed: R127.2, U58.8 (Rg)
unnamed: R128.1, U59.1 (Rg)
unnamed: R128.2, U59.8 (Rg)
unnamed: R129.1, U60.1 (Rg)
unnamed: R129.2, U60.8 (Rg)
unnamed: R130.1, U61.1 (Rg)
unnamed: R130.2, U61.8 (Rg)
unnamed: R21.2, R22.1, U6.3 (+)
unnamed: C6.1, C10.1, R9.2, U6.2 (-), U6.6
unnamed: C13.2, R16.1, U7.3 (+)
unnamed: R21.1, R27.1, U7.2 (-), U7.6
unnamed: R23.2, R24.1, U8.3 (+)
unnamed: C7.1, C12.1, R11.2, U8.2 (-), U8.6
unnamed: C15.2, R17.1, U9.3 (+)
unnamed: R23.1, R30.1, U9.2 (-), U9.6
unnamed: R25.2, R26.1, U10.3 (+)
unnamed: C8.1, C14.1, R13.2, U10.2 (-), U10.6
unnamed: C17.2, R18.1, U11.3 (+)
unnamed: R25.1, R33.1, U11.2 (-), U11.6
unnamed: R28.2, R29.1, U12.3 (+)
unnamed: C9.1, C16.1, R14.2, U12.2 (-), U12.6
unnamed: C19.2, R19.1, U13.3 (+)
unnamed: R28.1, R34.1, U13.2 (-), U13.6
unnamed: R31.2, R32.1, U14.3 (+)
unnamed: C11.1, C18.1, R15.2, U14.2 (-), U14.6
unnamed: C20.2, R20.1, U15.3 (+)
unnamed: R31.1, R35.1, U15.2 (-), U15.6
unnamed: C21.1, R36.2, U16.3 (+)
unnamed: R41.2, R42.1, U16.2 (-)
unnamed: C22.1, R37.2, U17.3 (+)
unnamed: R43.2, R44.1, U17.2 (-)
unnamed: C24.1, R38.2, U18.3 (+)
unnamed: R45.2, R46.1, U18.2 (-)
unnamed: C26.1, R39.2, U19.3 (+)
unnamed: R47.2, R48.1, U19.2 (-)
unnamed: C28.1, R40.2, U20.3 (+)
unnamed: R50.2, R51.1, U20.2 (-)
unnamed: C31.1, R49.2, U21.3 (+)
unnamed: U21.2 (-), U26.3 (RH)
unnamed: C32.1, R52.2, U22.3 (+)
unnamed: U22.2 (-), U27.3 (RH)
unnamed: C33.1, R53.2, U23.3 (+)
unnamed: U23.2 (-), U28.3 (RH)
unnamed: C34.1, R54.2, U24.3 (+)
unnamed: U24.2 (-), U29.3 (RH)
unnamed: C35.1, R55.2, U25.3 (+)
unnamed: U25.2 (-), U30.3 (RH)
unnamed: R56.1, U26.4 (RW)
unnamed: R57.1, U27.4 (RW)
unnamed: R58.1, U28.4 (RW)
unnamed: R59.1, U29.4 (RW)
unnamed: R60.1, U30.4 (RW)
unnamed: U32.3 (RH), U37.2 (-)
unnamed: R71.1, U32.4 (RW)
unnamed: U33.3 (RH), U38.2 (-)
unnamed: R72.1, U33.4 (RW)
unnamed: U34.3 (RH), U39.2 (-)
unnamed: R73.1, U34.4 (RW)
unnamed: U35.3 (RH), U40.2 (-)
unnamed: R74.1, U35.4 (RW)
unnamed: U36.3 (RH), U41.2 (-)
unnamed: R75.1, U36.4 (RW)
unnamed: C46.1, R76.2, U37.3 (+)
unnamed: C47.1, R77.2, U38.3 (+)
unnamed: C48.1, R78.2, U39.3 (+)
unnamed: C49.1, R79.2, U40.3 (+)
unnamed: C50.1, R82.2, U41.3 (+)
unnamed: C53.1, R91.2, U42.3 (+)
unnamed: R80.1, R81.2, U42.2 (-)
unnamed: C55.1, R92.2, U43.3 (+)
unnamed: R83.1, R84.2, U43.2 (-)
unnamed: C57.1, R93.2, U44.3 (+)
unnamed: R85.1, R86.2, U44.2 (-)
unnamed: C59.1, R94.2, U45.3 (+)
unnamed: R87.1, R88.2, U45.2 (-)
unnamed: C60.1, R95.2, U46.3 (+)
unnamed: R89.1, R90.2, U46.2 (-)
unnamed: C61.2, R111.1, U47.3 (+)
unnamed: R96.1, R100.1, U47.2 (-), U47.6
unnamed: R99.1, R100.2, U48.3 (+)
unnamed: C63.2, C70.2, R116.2, U48.2 (-), U48.6
unnamed: C62.2, R112.1, U49.3 (+)
unnamed: R97.1, R103.1, U49.2 (-), U49.6
unnamed: R102.1, R103.2, U50.3 (+)
unnamed: C65.2, C72.2, R117.2, U50.2 (-), U50.6
unnamed: C64.2, R113.1, U51.3 (+)
unnamed: R98.1, R106.1, U51.2 (-), U51.6
unnamed: R105.1, R106.2, U52.3 (+)
unnamed: C67.2, C73.2, R118.2, U52.2 (-), U52.6
unnamed: C66.2, R114.1, U53.3 (+)
unnamed: R101.1, R108.1, U53.2 (-), U53.6
unnamed: R107.1, R108.2, U54.3 (+)
unnamed: C69.2, C74.2, R120.2, U54.2 (-), U54.6
unnamed: C68.2, R115.1, U55.3 (+)
unnamed: R104.1, R110.1, U55.2 (-), U55.6
unnamed: R109.1, R110.2, U56.3 (+)
unnamed: C71.2, C75.2, R122.2, U56.2 (-), U56.6
Ref_Electrode: J1.30, U1.2 (-), U2.2 (-), U3.2 (-), U4.2 (-), U5.2 (-), U57.2 (-), U58.2 (-), U59.2 (-), U60.2 (-), U61.2 (-)
SDI: U26.10 (SDI), U27.10 (SDI), U28.10 (SDI), U29.10 (SDI), U30.10 (SDI), U31.13 (11_MOSI_CTX1), U32.10 (SDI), U33.10 (SDI), U34.10 (SDI), U35.10 (SDI), U36.10 (SDI)
Vss: J2.3, U1.7 (V+), U2.7 (V+), U3.7 (V+), U4.7 (V+), U5.7 (V+), U6.7 (V+), U7.7 (V+), U8.7 (V+), U9.7 (V+), U10.7 (V+), U11.7 (V+), U12.7 (V+), U13.7 (V+), U14.7 (V+), U15.7 (V+), U16.7 (V+), U17.7 (V+), U18.7 (V+), U19.7 (V+), U20.7 (V+), U21.7 (V+), U22.7 (V+), U23.7 (V+), U24.7 (V+), U25.7 (V+), U26.6 (Vdd+), U26.8 (Vlog), U27.6 (Vdd+), U27.8 (Vlog), U28.6 (Vdd+), U28.8 (Vlog), U29.6 (Vdd+), U29.8 (Vlog), U30.6 (Vdd+), U30.8 (Vlog), U32.6 (Vdd+), U32.8 (Vlog), U33.6 (Vdd+), U33.8 (Vlog), U34.6 (Vdd+), U34.8 (Vlog), U35.6 (Vdd+), U35.8 (Vlog), U36.6 (Vdd+), U36.8 (Vlog), U37.7 (V+), U38.7 (V+), U39.7 (V+), U40.7 (V+), U41.7 (V+), U42.7 (V+), U43.7 (V+), U44.7 (V+), U45.7 (V+), U46.7 (V+), U47.7 (V+), U48.7 (V+), U49.7 (V+), U50.7 (V+), U51.7 (V+), U52.7 (V+), U53.7 (V+), U54.7 (V+), U55.7 (V+), U56.7 (V+), U57.7 (V+), U58.7 (V+), U59.7 (V+), U60.7 (V+), U61.7 (V+)

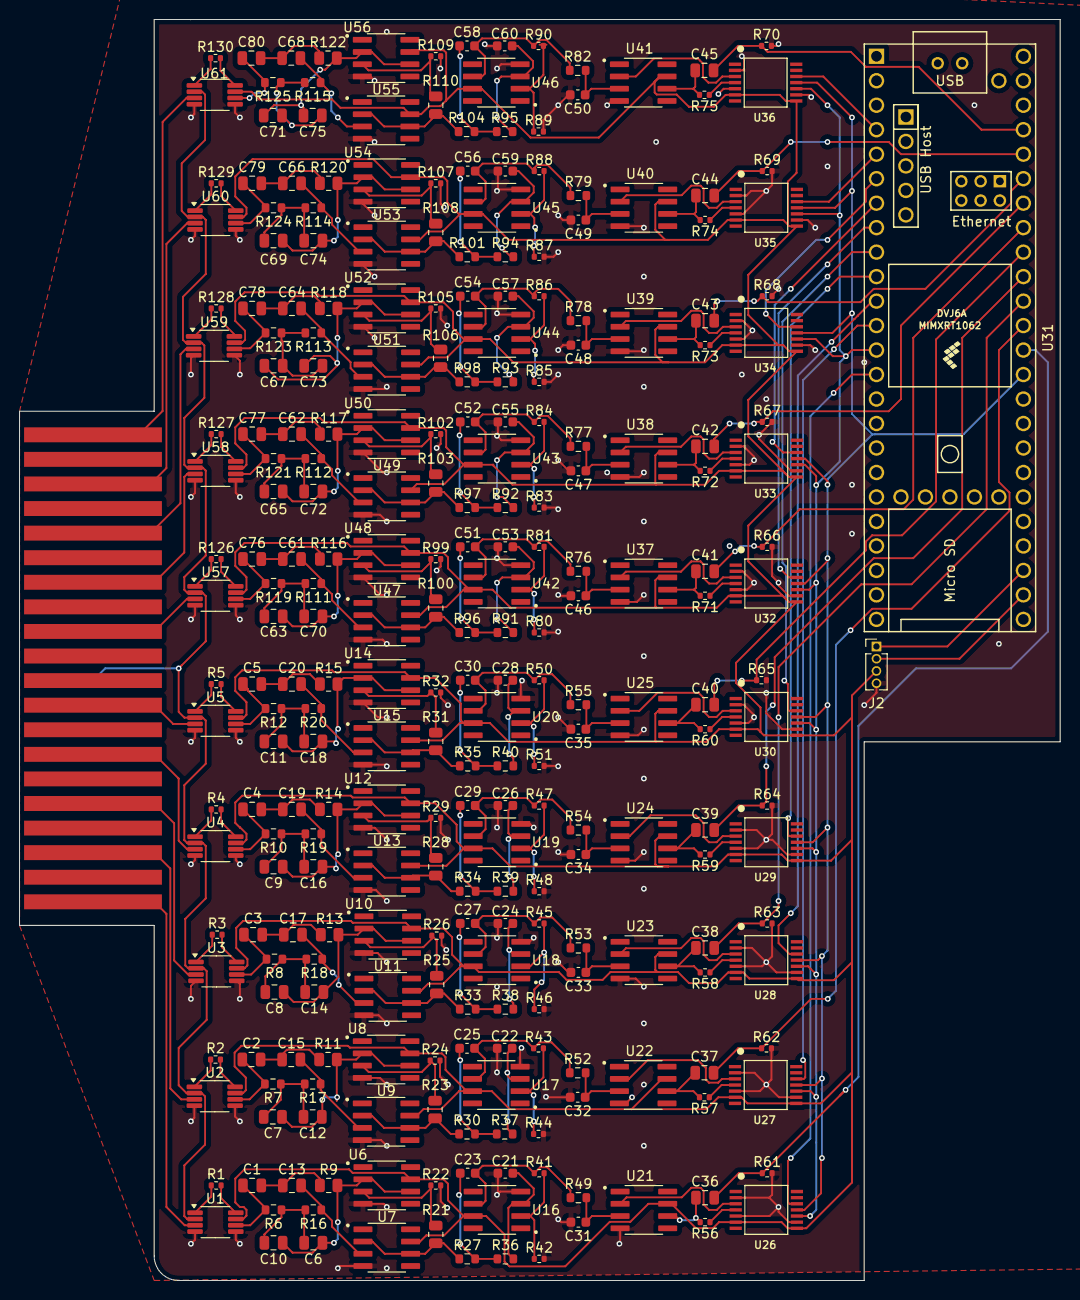
[picture p25: board EEG2.kicad_pcb from above]

Board: 2 copper layers, 108.0 x 130.8 mm, 273 parts (0 on the bottom side), 207 nets.
