jadoo-tech/Exoskeleton_public/Kicad Files/EEG — Seperated/Mother/Mother.kicad_pcb

## KiCad design Kicad Files/EEG — Seperated/Mother/Mother.kicad_pcb (2024-11-21)

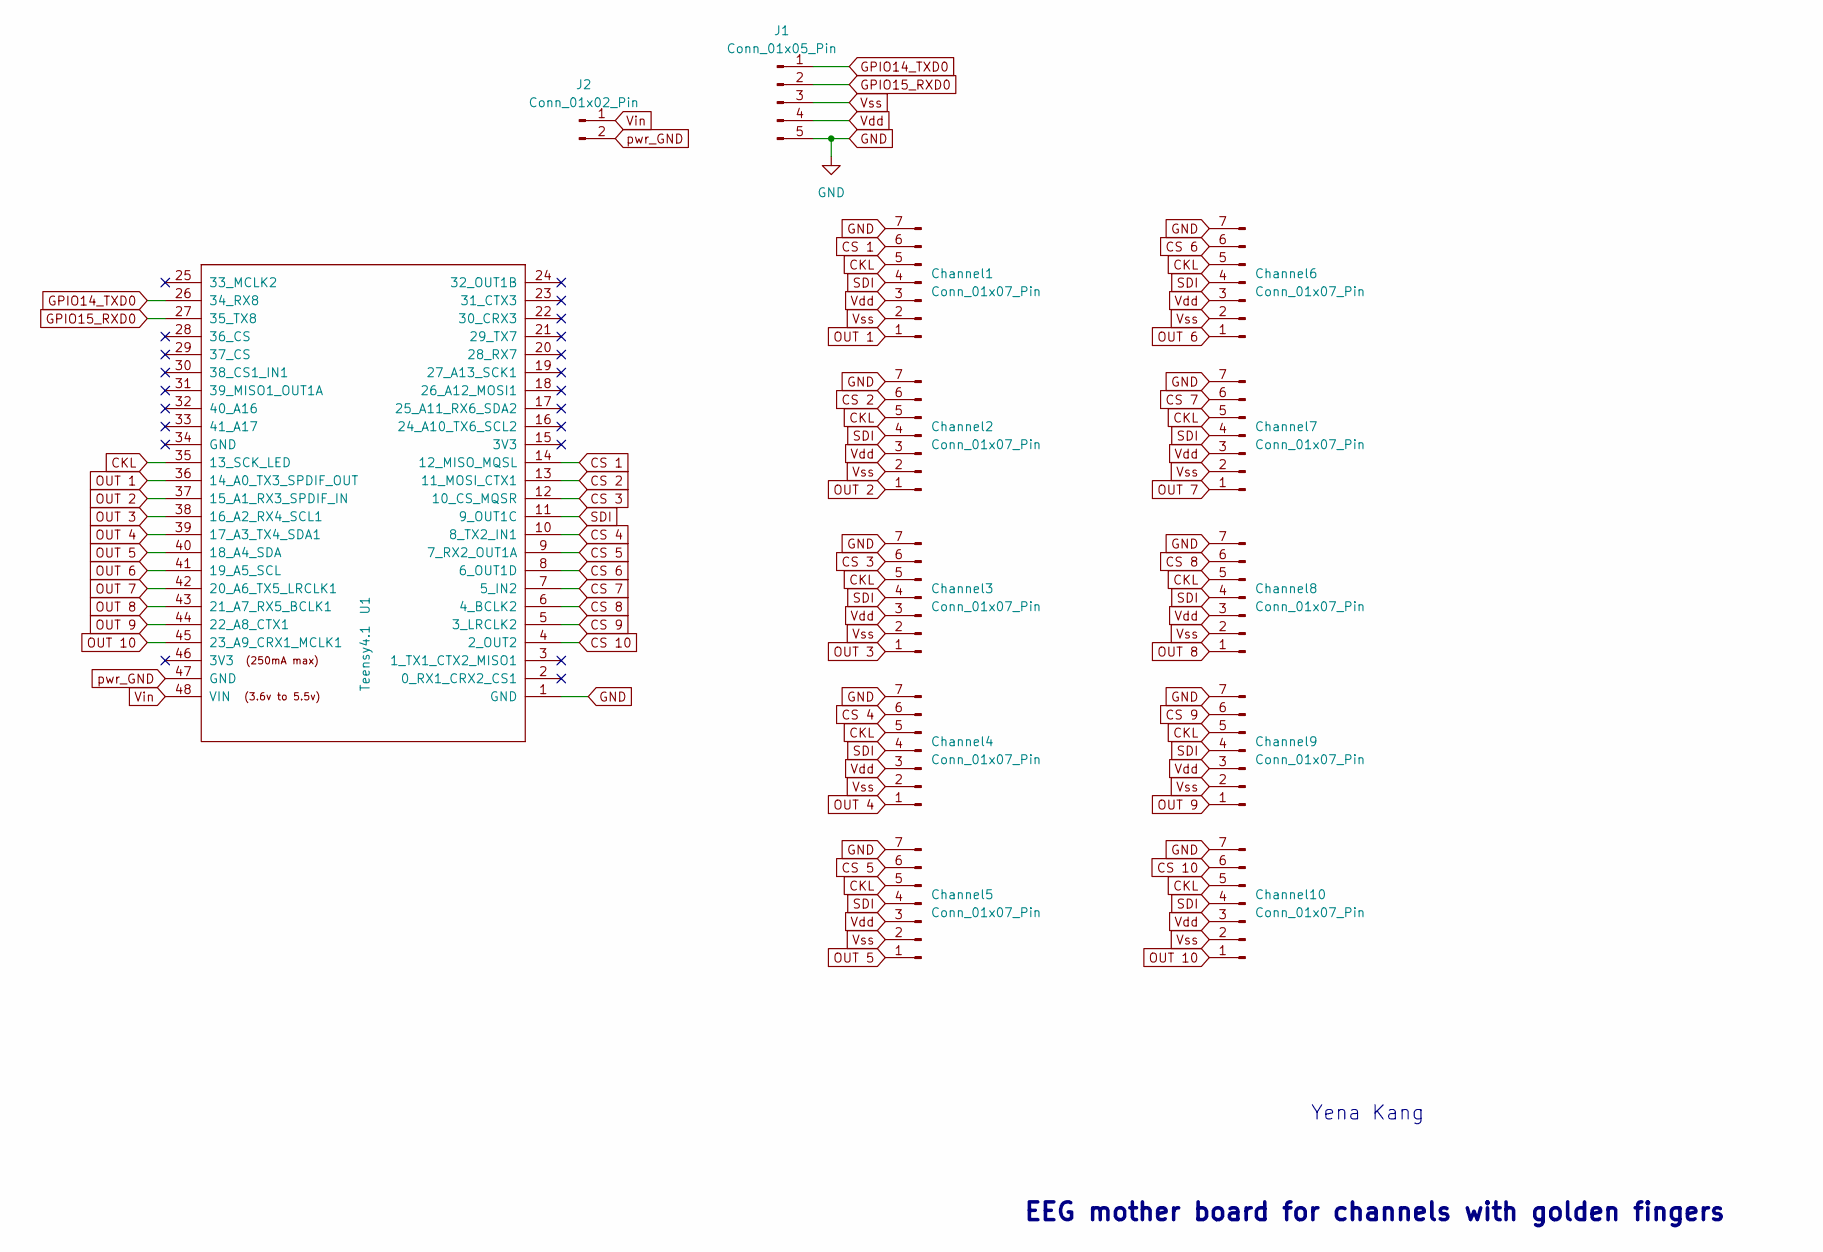
[picture p26: schematic Mother.kicad_sch]

Parts:
Channel1, Channel2, Channel3, Channel4, Channel5, Channel6, Channel7, Channel8, Channel9, Channel10: Conn_01x07_Pin; GoldFingers_1x07_P2.50mm
J1: Conn_01x05_Pin; PinHeader_1x05_P1.27mm_Vertical
J2: Conn_01x02_Pin; PinHeader_1x02_P1.27mm_Vertical
U1: Teensy4.1; Teensy41

Connections:
CKL: Channel1.5, Channel2.5, Channel3.5, Channel4.5, Channel5.5, Channel6.5, Channel7.5, Channel8.5, Channel9.5, Channel10.5, U1.35 (13_SCK_LED)
CS 1: Channel1.6, U1.14 (12_MISO_MQSL)
CS 2: Channel2.6, U1.13 (11_MOSI_CTX1)
CS 3: Channel3.6, U1.12 (10_CS_MQSR)
CS 4: Channel4.6, U1.10 (8_TX2_IN1)
CS 5: Channel5.6, U1.9 (7_RX2_OUT1A)
CS 6: Channel6.6, U1.8 (6_OUT1D)
CS 7: Channel7.6, U1.7 (5_IN2)
CS 8: Channel8.6, U1.6 (4_BCLK2)
CS 9: Channel9.6, U1.5 (3_LRCLK2)
CS 10: Channel10.6, U1.4 (2_OUT2)
GND: Channel1.7, Channel2.7, Channel3.7, Channel4.7, Channel5.7, Channel6.7, Channel7.7, Channel8.7, Channel9.7, Channel10.7, J1.5, U1.1 (GND)
GPIO14_TXD0: J1.1, U1.26 (34_RX8)
GPIO15_RXD0: J1.2, U1.27 (35_TX8)
OUT 1: Channel1.1, U1.36 (14_A0_TX3_SPDIF_OUT)
OUT 2: Channel2.1, U1.37 (15_A1_RX3_SPDIF_IN)
OUT 3: Channel3.1, U1.38 (16_A2_RX4_SCL1)
OUT 4: Channel4.1, U1.39 (17_A3_TX4_SDA1)
OUT 5: Channel5.1, U1.40 (18_A4_SDA)
OUT 6: Channel6.1, U1.41 (19_A5_SCL)
OUT 7: Channel7.1, U1.42 (20_A6_TX5_LRCLK1)
OUT 8: Channel8.1, U1.43 (21_A7_RX5_BCLK1)
OUT 9: Channel9.1, U1.44 (22_A8_CTX1)
OUT 10: Channel10.1, U1.45 (23_A9_CRX1_MCLK1)
SDI: Channel1.4, Channel2.4, Channel3.4, Channel4.4, Channel5.4, Channel6.4, Channel7.4, Channel8.4, Channel9.4, Channel10.4, U1.11 (9_OUT1C)
Vdd: Channel1.3, Channel2.3, Channel3.3, Channel4.3, Channel5.3, Channel6.3, Channel7.3, Channel8.3, Channel9.3, Channel10.3, J1.4
Vin: J2.1, U1.48 (VIN)
Vss: Channel1.2, Channel2.2, Channel3.2, Channel4.2, Channel5.2, Channel6.2, Channel7.2, Channel8.2, Channel9.2, Channel10.2, J1.3
pwr_GND: J2.2, U1.47 (GND)

Notes on the sheet:
EEG mother board for channels with golden fingers
Yena Kang

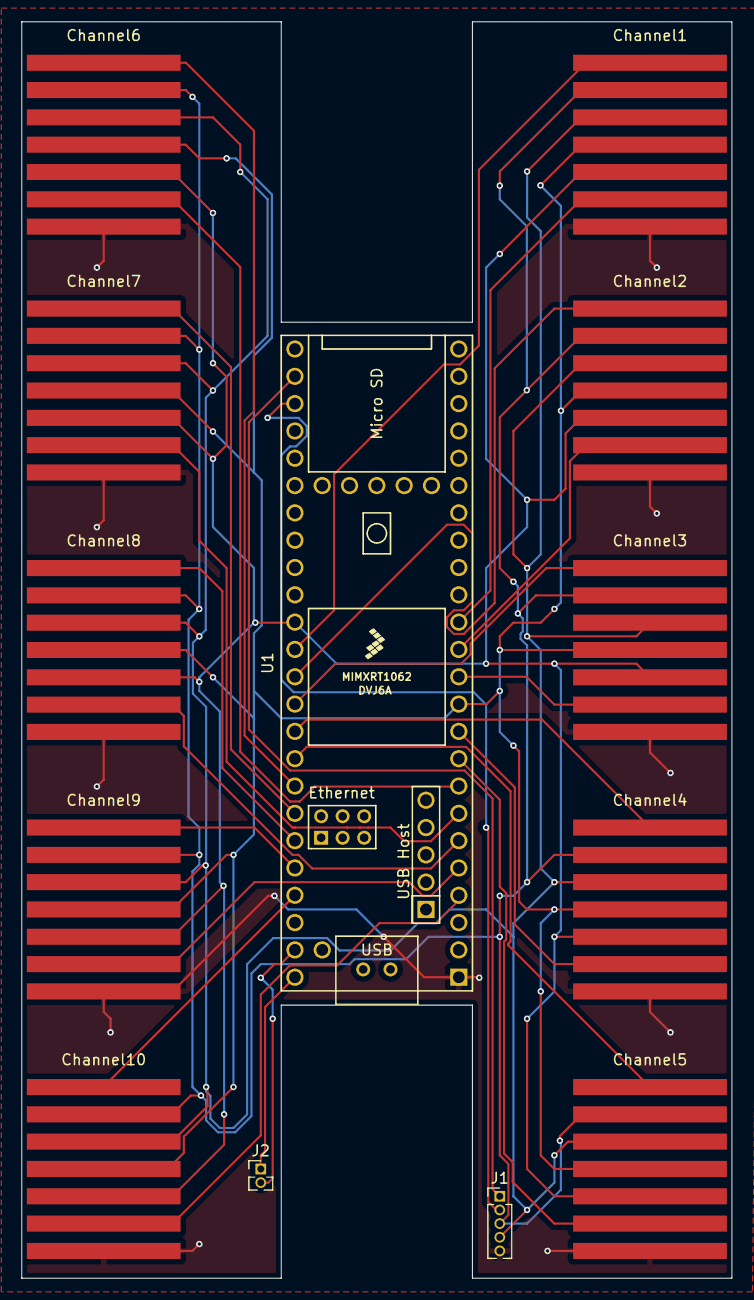
[picture p27: board Mother.kicad_pcb from above]

Board: 2 copper layers, 66.0 x 116.8 mm, 13 parts (0 on the bottom side), 29 nets.
