jadoo-tech/Exoskeleton_public/Kicad Files/EEG — Seperated/Channel/Channel.kicad_pcb

## KiCad design Kicad Files/EEG — Seperated/Channel/Channel.kicad_pcb (2024-11-20)

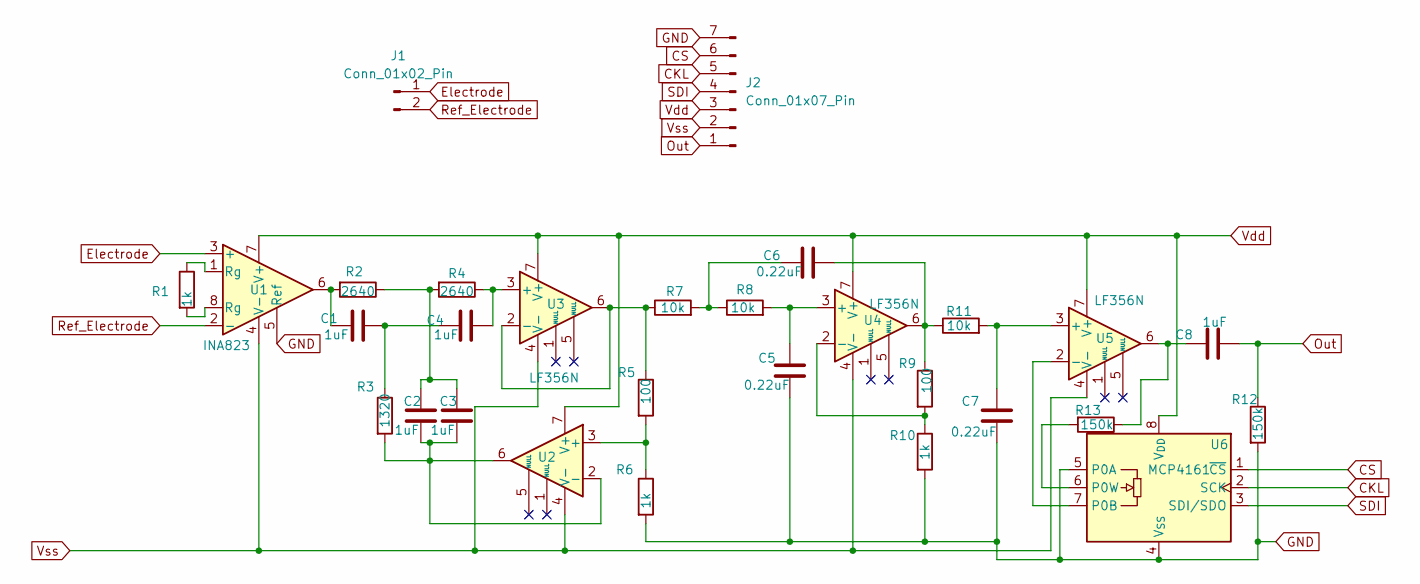
[picture p28: schematic Channel.kicad_sch]

Parts:
C1, C2, C3, C4, C8: 1uF; C_0805_2012Metric
C5, C6, C7: 0.22uF; C_0603_1608Metric
J1: Conn_01x02_Pin; PinHeader_1x02_P2.00mm_Vertical
J2: Conn_01x07_Pin; GoldFingers_1x07_P2.50mm
R1, R6, R10: 1k; R_0402_1005Metric_Pad0.72x0.64mm_HandSolder
R2, R4: 2640; R_0603_1608Metric_Pad0.98x0.95mm_HandSolder
R3: 1320; R_0805_2012Metric_Pad1.20x1.40mm_HandSolder
R5, R9: 100; R_0805_2012Metric_Pad1.20x1.40mm_HandSolder
R7, R8, R11: 10k; R_0603_1608Metric_Pad0.98x0.95mm_HandSolder
R12, R13: 150k; R_0402_1005Metric_Pad0.72x0.64mm_HandSolder
U1: INA823; VSSOP-8_3x3mm_P0.65mm
U2, U3, U4, U5: LF356N; SOIC127P599X175-8N
U6: MCP4161; DIP-8_W7.62mm_Socket

Connections:
CKL: J2.5, U6.2 (SCK)
CS: J2.6, U6.1 (~CS)
Electrode: J1.1, U1.3 (+)
GND: C5.2, C7.2, J2.7, R6.2, R10.2, R12.2, U1.5 (Ref), U6.4 (V_{SS}), U6.5 (P0A)
unnamed: C1.1, R2.2, U1.6
unnamed: C1.2, C4.1, R3.1
unnamed: C2.1, C3.1, R2.1, R4.2
unnamed: C6.1, R9.1, R11.1, U4.6
unnamed: C6.2, R7.2, R8.1
unnamed: R1.1, U1.1 (Rg)
unnamed: R1.2, U1.8 (Rg)
unnamed: R5.2, R6.1, U2.3 (+)
unnamed: C2.2, C3.2, R3.2, U2.2 (-), U2.6
unnamed: C4.2, R4.1, U3.3 (+)
unnamed: R5.1, R7.1, U3.2 (-), U3.6
unnamed: C5.1, R8.2, U4.3 (+)
unnamed: R9.2, R10.1, U4.2 (-)
unnamed: C7.1, R11.2, U5.3 (+)
unnamed: U5.2 (-), U6.7 (P0B)
Out: C8.2, J2.1, R12.1
Ref_Electrode: J1.2, U1.2 (-)
SDI: J2.4, U6.3 (SDI/SDO)
Vdd: J2.3, U1.7 (V+), U2.7 (V+), U3.7 (V+), U4.7 (V+), U5.7 (V+), U6.8 (V_{DD})
Vss: J2.2, U1.4 (V-), U2.4 (V-), U3.4 (V-), U4.4 (V-), U5.4 (V-)

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
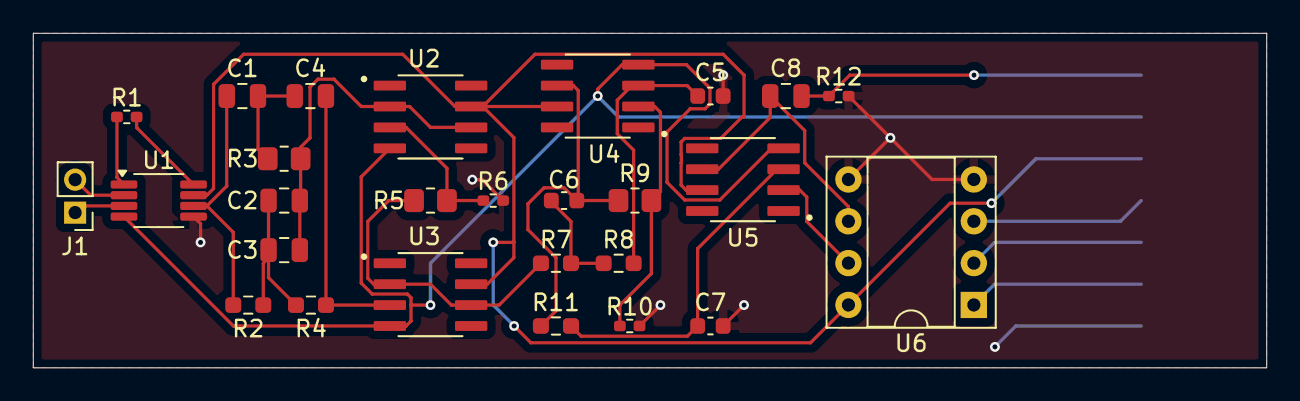
[picture p29: board Channel.kicad_pcb from above]

Board: 2 copper layers, 74.9 x 20.3 mm, 28 parts (1 on the bottom side), 25 nets.
