jadoo-tech/Exoskeleton_public/Kicad Files/Integration Circuit/Integration Circuit.kicad_pcb

## KiCad design Kicad Files/Integration Circuit/Integration Circuit.kicad_pcb (2024-10-15)

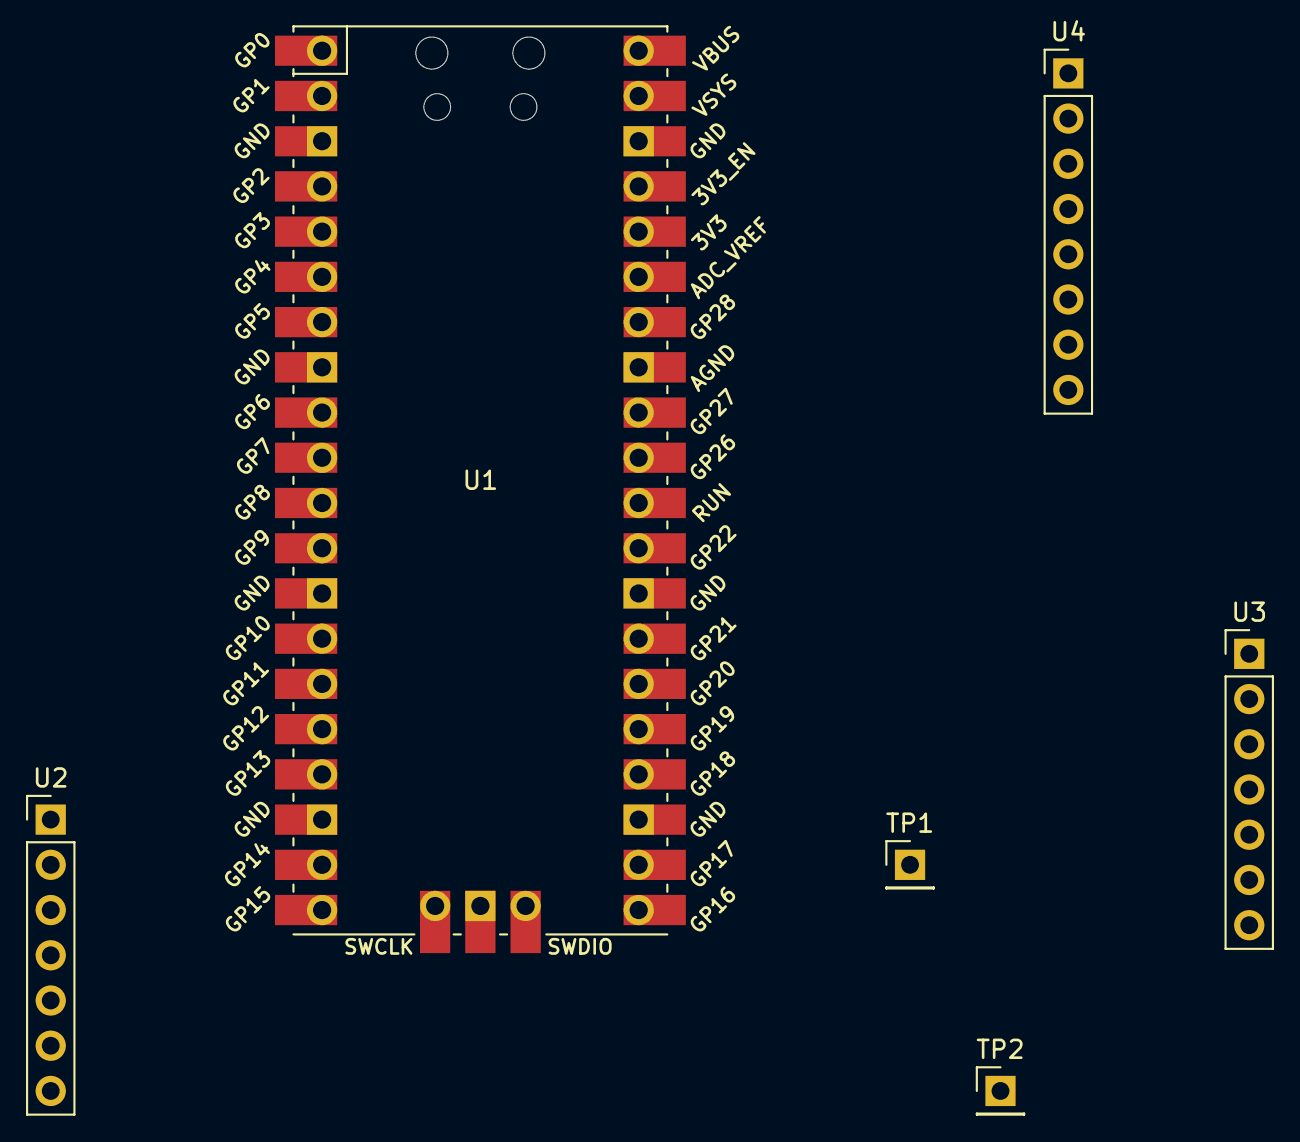
[picture p30: board Integration Circuit.kicad_pcb from above]

Board: 2 copper layers, 6 parts (0 on the bottom side), 16 nets, no tracks yet.

Parts:
TP1, TP2: TestPoint; PinHeader_1x01_P2.54mm_Vertical
U1: Pico; RPi_Pico_SMD_TH
U2, U3: OLED Driver; PinHeader_1x07_P2.54mm_Vertical
U4: Camera; PinHeader_1x08_P2.54mm_Vertical

Connections:
+3.3V: TP2.1, U1.36 (3V3), U2.1 (VCC), U3.1 (VCC), U4.1 (VCC)
GND: TP1.1, U1.3 (GND), U1.8 (GND), U1.13 (GND), U1.18 (GND), U1.23 (GND), U1.28 (GND), U1.33 (AGND), U1.38 (GND), U1.42 (GND), U2.2 (GND), U3.2 (GND), U4.8 (GND)
GP2: U1.4 (GPIO2), U2.4 (CLK), U3.4 (CLK)
GP3: U1.5 (GPIO3), U2.3 (DIN), U3.3 (DIN)
GP5: U1.7 (GPIO5), U3.5 (CS)
GP6: U1.9 (GPIO6), U3.7 (RST)
GP7: U1.10 (GPIO7), U3.6 (DC)
GP10: U1.14 (GPIO10), U4.7 (DO)
GP13: U1.17 (GPIO13), U2.5 (CS)
GP14: U1.19 (GPIO14), U2.7 (RST)
GP15: U1.20 (GPIO15), U2.6 (DC)
GP16: U1.21 (GPIO16), U4.4 (VSYNC)
GP18: U1.24 (GPIO18), U4.6 (PCLK)
GP19: U1.25 (GPIO19), U4.5 (HREF)
GP20: U1.26 (GPIO20), U4.3 (SDA)
GP21: U1.27 (GPIO21), U4.2 (SCL)
