jadoo-tech/Exoskeleton_public/(commit log)

2024-08-28 working base
    [data.csv]
2024-09-06 Displaying video to monitor from client camera added
2024-09-23 EEG Files from August
    [teensy_data.csv]
2024-09-24 Video half working
    timeout = 300, so 5 min of camera display in gunicorn.config.py
2024-10-15 PCB files — Previous EEG Uploaded
    [EEG Circuits.kicad_pcb, EEG Circuits.kicad_sch]
2024-10-15 Final demo PCB with AR Glass Pins Corrected
    [Glass-B_Cu.dxf, Glass-B_Mask.dxf, Glass-B_Paste.dxf, Glass-B_Silkscreen.dxf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]
2024-10-15 Limbs & Motherboard Circuit uploaded —Needs update
    [Integration Circuit.kicad_pcb, Integration Circuit.kicad_sch, Limbs Control.kicad_pcb, Limbs Control.kicad_sch, untitled.kicad_sch]
2024-10-19 Rearrange EEG directory
    [teensy_data.csv]
2024-10-19 EEG Updated
    [EEG2.kicad_pcb, EEG2.kicad_sch]
2024-10-19 Schematic Errors Fixed, some footprints done
    [EEG2.kicad_sch]
2024-11-01 Add files via upload
    Redo the circuit with waqas's insisted potentiometer and added BOM
    [EEGBOM.xls, EEG_halloween.kicad_sch]
2024-11-18 EEG new PCB done
    [AD5293.step, Adafruit DS3502 .kicad_pcb, Adafruit DS3502 .kicad_sch, Channel.kicad_pcb, Channel.kicad_sch, EEG2.kicad_sch, LF356M.step, Mother.kicad_pcb]
2024-11-18 Gerber generated
    [Channel-B_Cu.gbr, Channel-B_Mask.gbr, Channel-B_Paste.gbr, Channel-B_Silkscreen.gbr, Channel-Edge_Cuts.gbr, Channel-F_Cu.gbr, Channel-F_Mask.gbr, Channel-F_Paste.gbr]
2024-11-20 heating_circuit rough draft completed
    [Heating Circuit.kicad_pcb, Heating Circuit.kicad_sch]
2024-11-20 Added silkscreen and mounting holes
    [Heating Circuit.kicad_pcb]
2024-11-20 Minor schematic changes
    [Heating Circuit.kicad_sch]
2024-11-20 AR revised
    [Channel-B_Cu.gbr, Channel-B_Mask.gbr, Channel-B_Paste.gbr, Channel-B_Silkscreen.gbr, Channel-Edge_Cuts.gbr, Channel-F_Cu.gbr, Channel-F_Mask.gbr, Channel-F_Paste.gbr]
2024-11-20 AR changed
    [Glass.kicad_pcb]
2024-11-20 Motor moved
    [Limbs Control.kicad_pcb, Limbs Control.kicad_sch, untitled.kicad_sch]
2024-11-20 Added ground plane
    [Heating Circuit.kicad_pcb]
2024-11-20 some more movements
    [Integration Circuit.kicad_pcb, Integration Circuit.kicad_sch]
2024-11-20 Heater Checked
    [Heating Circuit.kicad_pcb, Heating Circuit.kicad_sch]
2024-11-20 Fixed schematics
    [Heating Circuit.kicad_sch]
2024-11-21 EEG Power Updated
    [EEG2.kicad_pcb, EEG2.kicad_sch, EEGBOM.xls, Mother.kicad_pcb, Mother.kicad_sch]
2024-12-05 Corrections in EEG
    [Channel.kicad_sch, EEG2.kicad_pcb, EEG2.kicad_sch]
2024-12-05 Working on EEG
    [EEG2.kicad_pcb, EEG2.kicad_sch]
2024-12-08 Fixed PWM direction, rerouted PCB trades
    [Heating Circuit.kicad_pcb, Heating Circuit.kicad_sch]
2024-12-08 EEG Done and some rearrangements
    [Channel-B_Cu.gbr, Channel-B_Mask.gbr, Channel-B_Paste.gbr, Channel-B_Silkscreen.gbr, Channel-Edge_Cuts.gbr, Channel-F_Cu.gbr, Channel-F_Mask.gbr, Channel-F_Paste.gbr]
2024-12-08 AR modified
    [Glass.kicad_pcb]
2024-12-08 Create ~Heating Circuit.kicad_pcb.lck
2024-12-19 AR & EEG corrected
    [EEG2.kicad_pcb, EEG2.kicad_sch, Glass.kicad_pcb]
2025-02-01 EEG done
    [EEG2.kicad_pcb]
2025-02-12 Create Heating Circuit-2024-12-08_114526.zip
2025-02-16 Fixed heating circuit track width
    [Heating Circuit.kicad_pcb]
2025-02-16 added thicker traces for heater power
    [Heating Circuit.kicad_pcb]
2025-03-08 adding gyroscope
    [Limb_Circuit.kicad_pcb, Limb_Circuit.kicad_sch]
2025-03-08 Renamed File
    [Limb_Circuit.kicad_pcb, Limb_Circuit.kicad_sch]
2025-03-09 Added gyroscope
    [Exoskeleton BOM - Limb Circuit.csv, Limb_Circuit.kicad_pcb, Limb_Circuit.kicad_sch]
2025-03-09 Added BOM
2025-03-09 Updated BOM
2025-03-16 limb circuit updates
    [Limb_Circuit.kicad_pcb, Limb_Circuit.kicad_sch]
2025-03-16 Finished limb circuit board
    [Limb_Circuit.kicad_pcb, Limb_Circuit.kicad_sch]
2025-06-09 some changes
    [EEGBOM.xls, Exoskeleton BOM - Limb Circuit.csv, Glass.kicad_pcb, Glass.kicad_sch, Limb_Circuit.kicad_pcb, Limb_Circuit.kicad_sch]
2025-06-29 Video Display Test -- Some errors fixed
    [constants.py, execCommands.py, videoDisplay.py]
2025-09-09 Last Update for 2025 (Server)
    [data.csv]
2025-09-09 Revert "Last Update for 2025 (Server)"
    This reverts commit c78feff2333a2c4fa5fcf5af88a9c686a0c6de23.
    [data.csv]
2025-09-09 Kicad & Microcontroller Restored
